ianm8/MBPTRX/README.md

# MBPTRX
A software defined multi-band phasing transceiver. See the [Manual](https://github.com/ianm8/MBPTRX/blob/main/docs/manual/MBPTRX_User_Manual.md) for further details.

## Some Specifications
 * SSB, CW, FM, FT8, Other digital modes using vox
 * 80m - 10m, nominally 10W
 * 3.5MHz - 30MHz SWL including AM
 * 30 KHz spectrum display
 * Noise reduction
 * Noise blanker
 * Notch filter

Here is a block diagram:

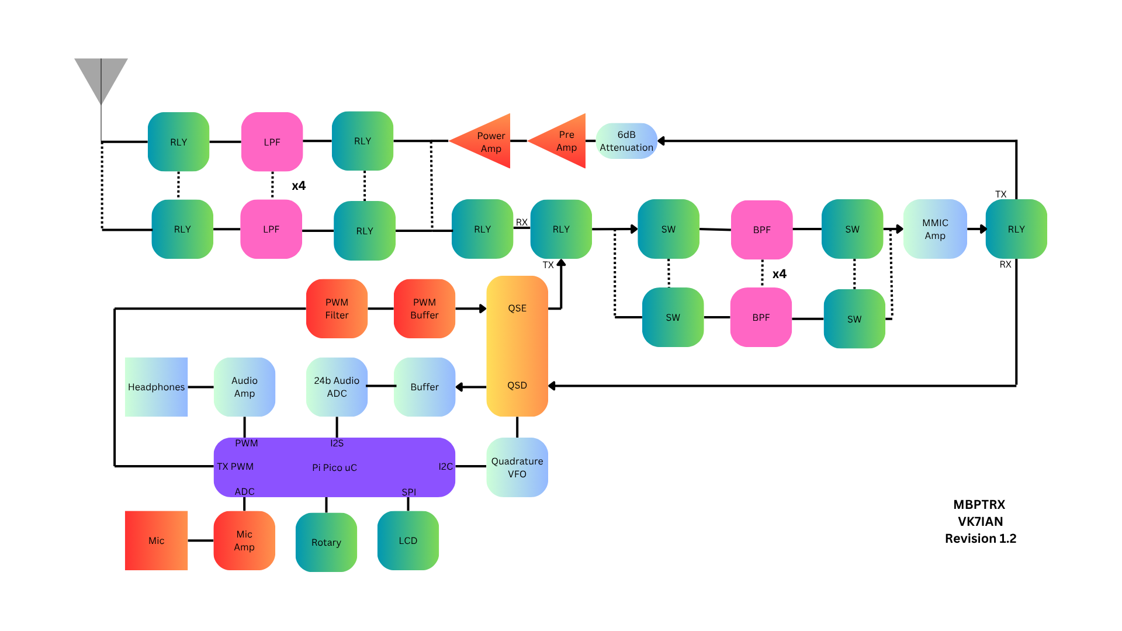
[picture p1: docs/MBPTRX.png]


Built in FT8:



Completed PCB:

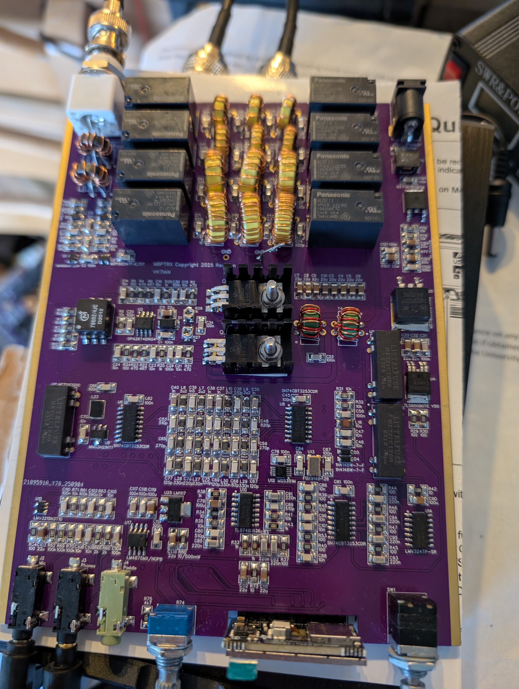
[picture p2: docs/MBPTRX-PCB-Complete.jpg]


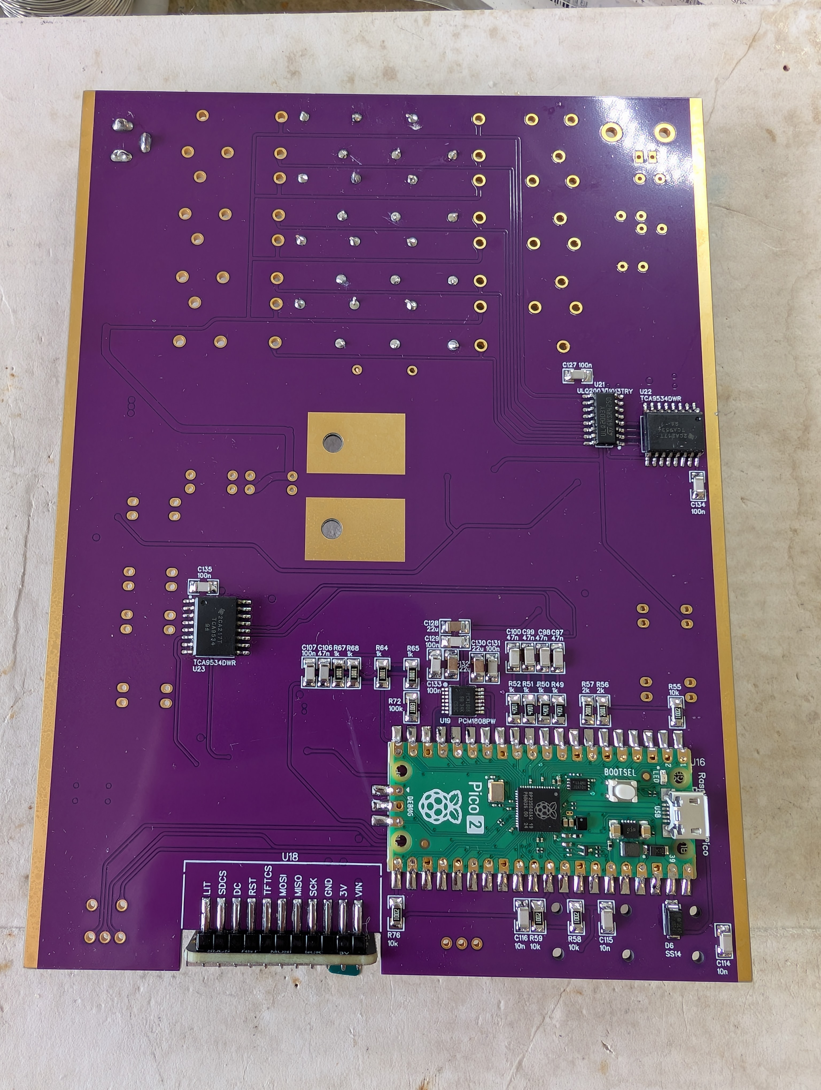
[picture p3: docs/MBPTRX-PCB-Bottom.jpg]


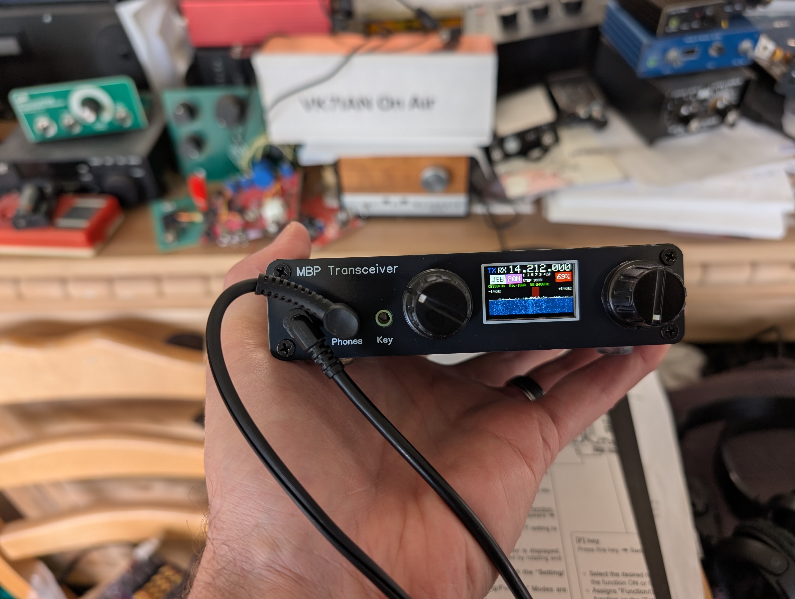
[picture p4: docs/MBPTRX-Boxed.jpg]


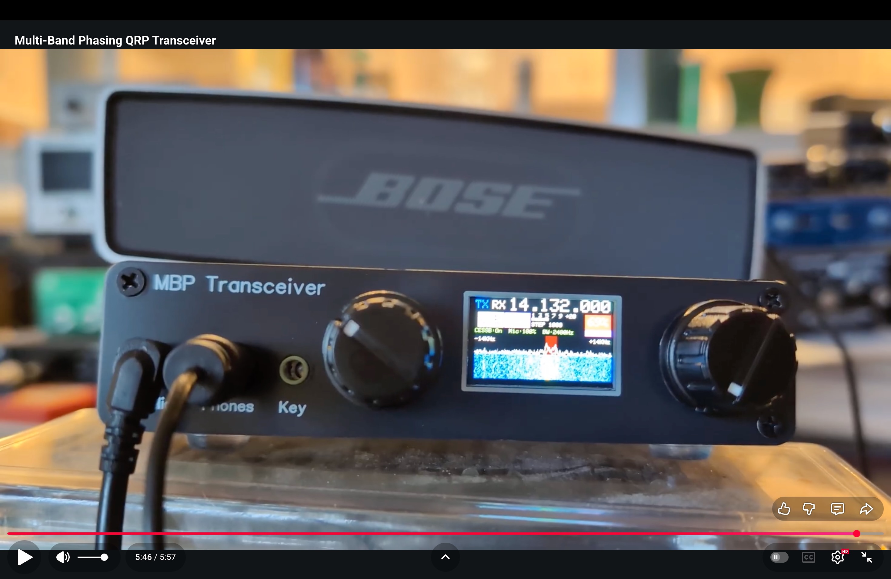
[picture p5: docs/MBPTRX-Short-Video.jpeg]
IMAGE ALT TEXT HERE (https://www.youtube.com/watch?v=c6KUVnFJ4gM)


73 VK7IAN
