ianm8/MBPTRX/src/README.md

## Libraries
 *  ~~https://github.com/Bodmer/TFT_eSPI~~
 *  A modified version of this library is now included
 *  Install the TFT_eSPI2 library provided in the **release** files
 *  This version adds a **displayOn()** function so that the display can be initialised and cleared before being switched on
 
## Build
 *  Pi Pico 2
 *  CPU Speed: 240Mhz
 *  Optimize: -O3
 *  USB Stack: No USB
 *  Flash Size: 4MB (no FS)

## Some history
 * 0.1.240 start with uSBITX and iqSDR40 code
 * 0.2.240 fix read I2C port bug
 * 0.3.240 fix RX/TX relay bug
 * 0.4.240 spectrum level
 * 0.5.240 direct CW
 * 0.6.240 complex mixer offset
 * 0.7.240 update bandwidths
 * 0.8.240 enable EEPROM writes
 * 0.9.240 fix CW display width
 * 1.0.240 RX bandwith options
 * 1.1.240 code cleanup
 * 1.2.240 fix SWR display
 * 1.3.240 graph power and SWR
 * 1.4.240 set spectrum level
 * 1.5.240 exit level if TX
 * 1.6.240 smeter sensitivity higher bands
 * 1.7.240 change TX frequency colour
 * 1.8.240 fix CW display position
 * 2.0.240 AM mode for SWL band
 * 2.1.240 improved AM demodulation
 * 2.2.240 include modified TFT_eSPI library
 * 2.3.240 fix TFT display initialisation
 * 2.4.240 separate modified TFT_eSPI2 library
 * 2.5.240 add exit option to JNR menu
 * 2.6.240 noise blanker
 * 2.7.240 TX/RX transition glitch
 * 2.8.240 reposition status info
 * 2.9.240 tweak noise blanker
 * 3.0.240 mic processor
 * 3.1.240 CW decoder - adaptive
 * 3.2.240 CW decoder - schmitt
 * 3.3.240 spectrum set or adjust
 * 3.4.240 update fonts
 * 4.0.240 digital mode with Vox
 * 4.1.240 don't show JNR in DIG mode
 * 4.2.240 lower sideband digital
 * 4.3.240 TX guard on startup
 * 4.4.240 minor update to spectrum processing
 * 5.0.240 FT8 built in
 * 5.1.240 FT8 refactor button press
 * 5.2.240 FT8 menu options
 * 5.3.240 FT8 pop-up CQ or response
 * 5.4.240 spectrum process regression
 * 5.5.240 FT8 progress resets on long press
 * 5.6.240 FT8 modifier seen as callsign
 * 5.7.240 FT8 fix frozen age colour
 * 5.8.240 FT8 detect poached QSO
 * 5.9.240 fix s-meter sensitivity
 * 6.0.240 improved spectrum (pedestal)
 * 6.1.240 improved CESSB
 * 6.2.240 improved sensitivity (AGC)
 * 6.3.240 core separate stacks
 * 6.4.240 notch filter
 * 6.5.240 reduce spectrum stack usage
 * 6.6.240 fix SWR graph mode
 * 6.7.240 fix frequency step
 * 6.8.240 move DSP to core1
 * 6.9.240 add popups
 * 7.0.240 user set callsign
 * 7.1.240 FT8 AGC display
 * 7.2.240 cw.h -> CW.h
 * 7.3.240 remove rotary err catch
 * 7.4.240 FT8 hashtable bounds
 * 7.5.240 ADC interrupt core1
 * 7.6.240 enforce build options
 * 7.7.240 improve all-pass accuracy
 * 7.8.240 improve noise blanker
 * 7.9.240 improve spectrum gain
 * 8.0.240 improve CW shaping
 * 8.1.240 FT8 auto-calibrate
 * 8.2.240 move mode auto
 * 8.3.240 add 10000 to quick step
 * 8.4.240 fix I2S backlog issue
 * 8.5.240 iambic A and B keyer
 * 8.6.240 FT8 monitoring
 * 8.7.240 robust float FFT
 * 8.8.240 FT8 unmute if monitoring
 * 8.9.240 FT8 clear autocal
 * 9.0.240 remove unused gaussian
 * 9.1.240 FT8 on Ham band only
 * 9.2.240 fix call entry message
 * 9.3.240 fix CW sidetone
 * 9.4.240 fix sidetone level
 * 9.5.240 FT8 autocal lock
 * 9.6.240 FT8 autocal shows first attempt
 * 9.7.240 add narrow band FM
