ianm8/MBPTRX/docs/PCB-Bottom-Photo-View.png

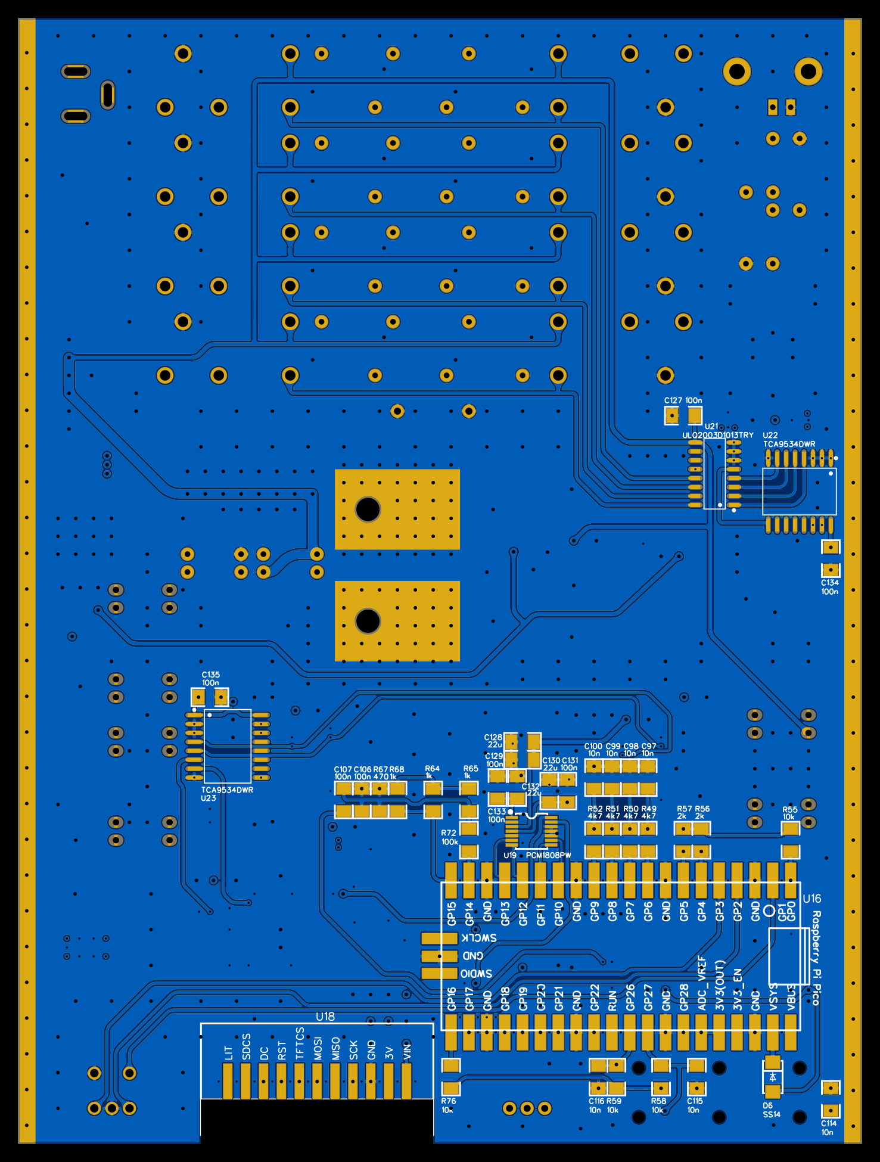
docs/PCB-Bottom-Photo-View.png
