ianm8/MBPTRX/docs/PCB-Top-Photo-View.png

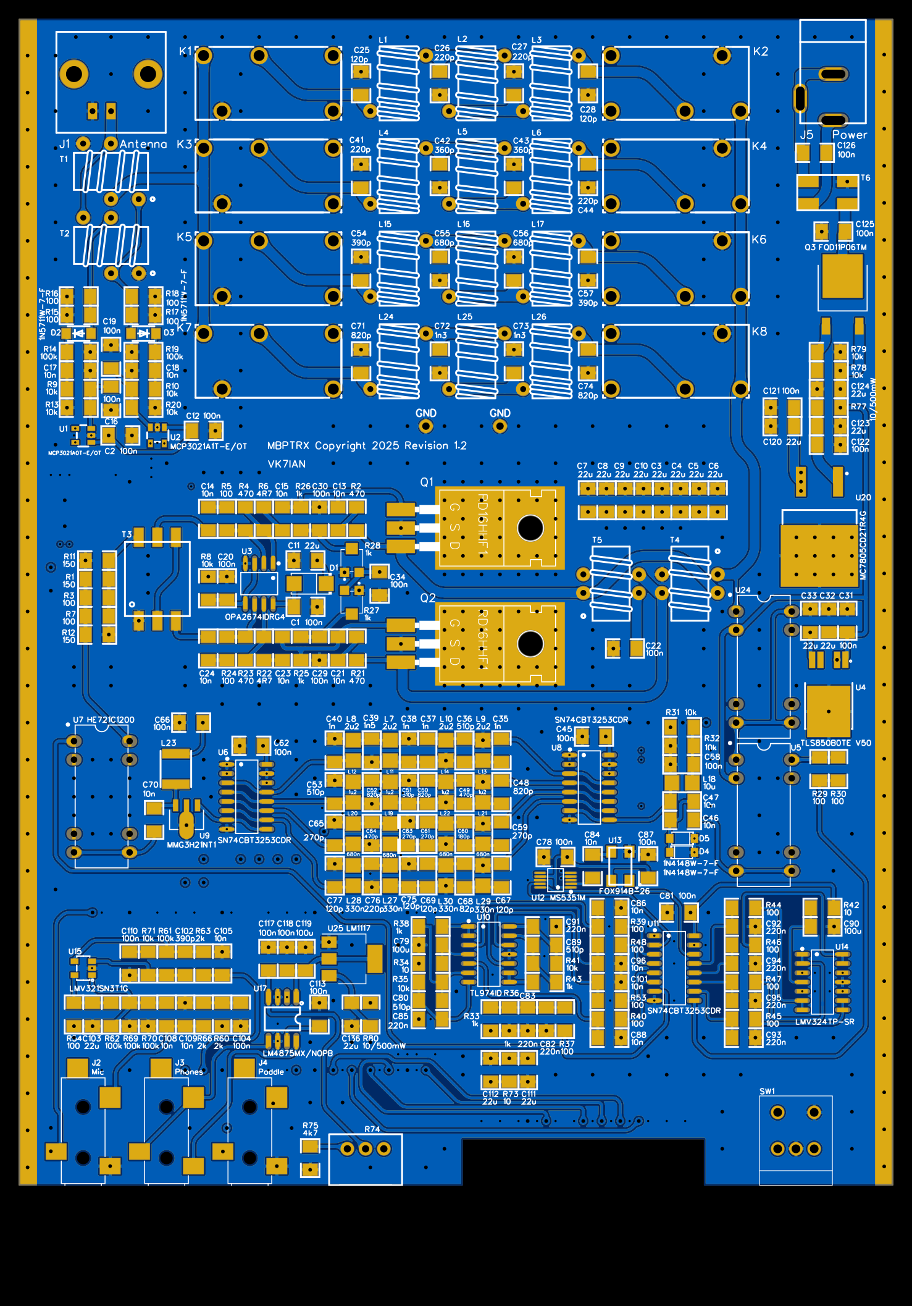
docs/PCB-Top-Photo-View.png
