ianm8/MBPTRX/docs/PXL_20250908_184102633.jpg

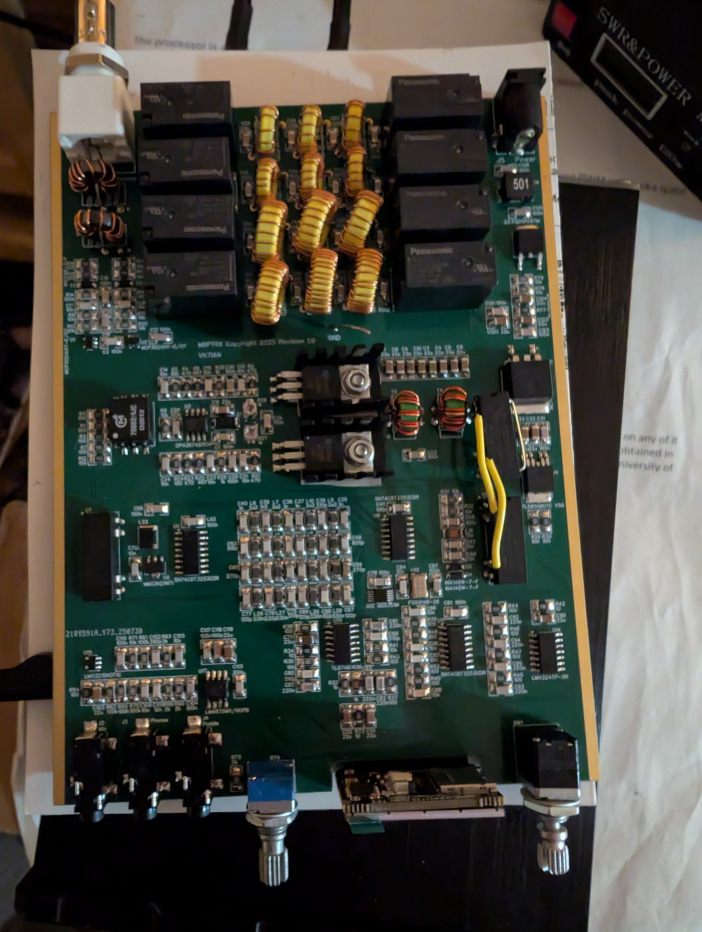
docs/PXL_20250908_184102633.jpg
