ianm8/MBPTRX/docs/suppression/RigolDS1-80M.png

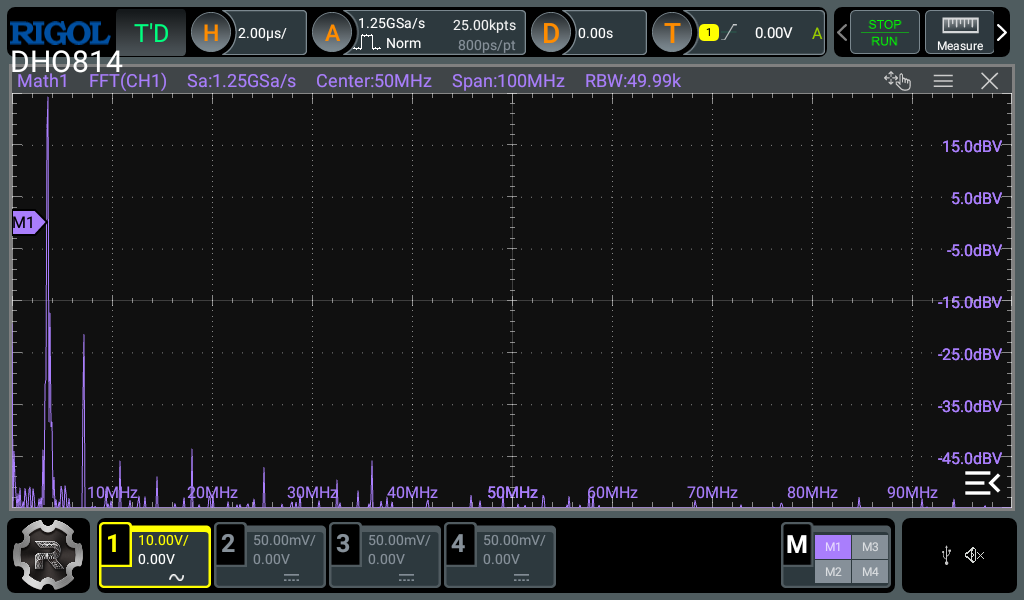
docs/suppression/RigolDS1-80M.png
