ianm8/MBPTRX/docs/suppression/RigolDS4-20M.png

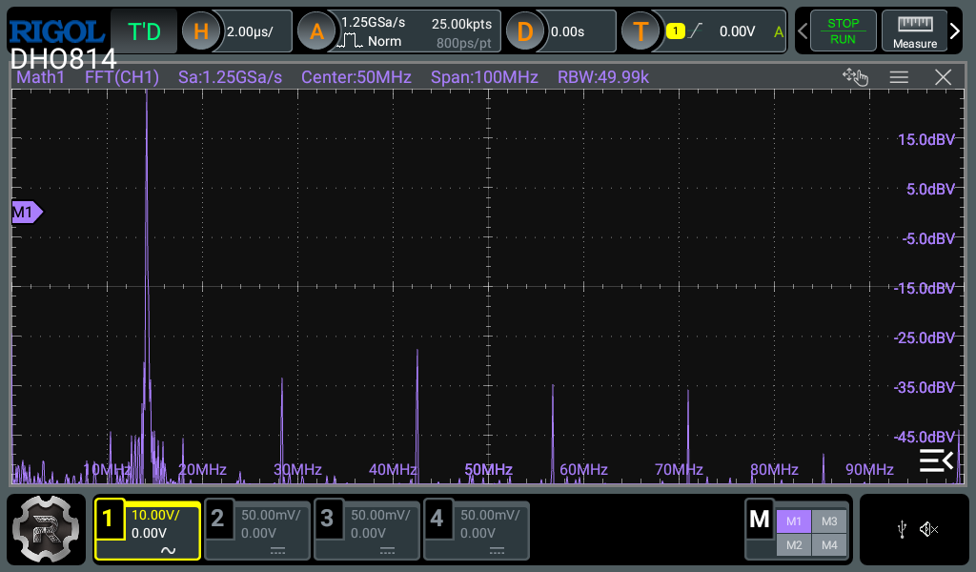
docs/suppression/RigolDS4-20M.png
