ianm8/MBPTRX/docs/suppression/RigolDS5-17M.png

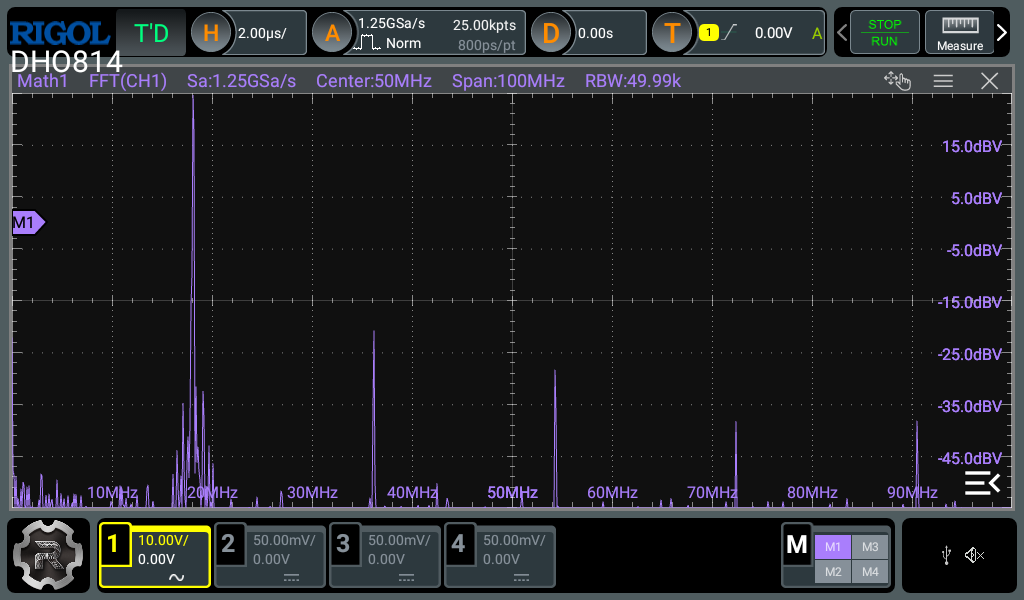
docs/suppression/RigolDS5-17M.png
