ianm8/MBPTRX/docs/suppression/RigolDS6-15M.png

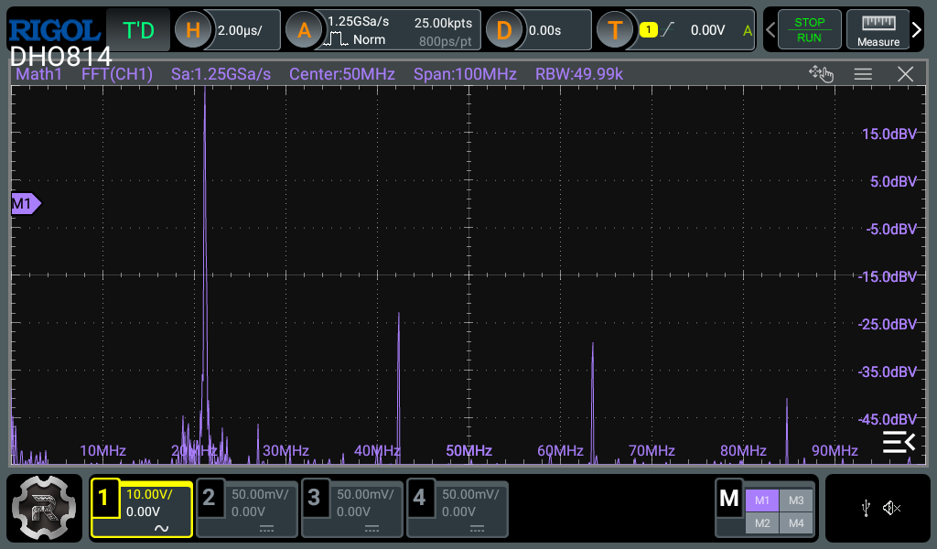
docs/suppression/RigolDS6-15M.png
