ianm8/MBPTRX/docs/suppression/RigolDS7-12M.png

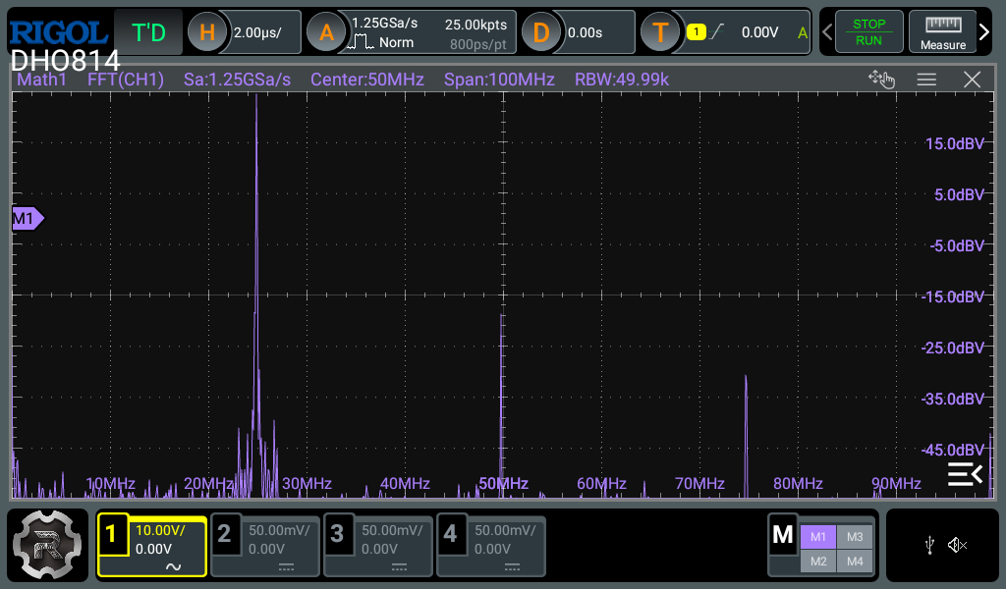
docs/suppression/RigolDS7-12M.png
