ianm8/MBPTRX/docs/suppression/RigolDS8-10M.png

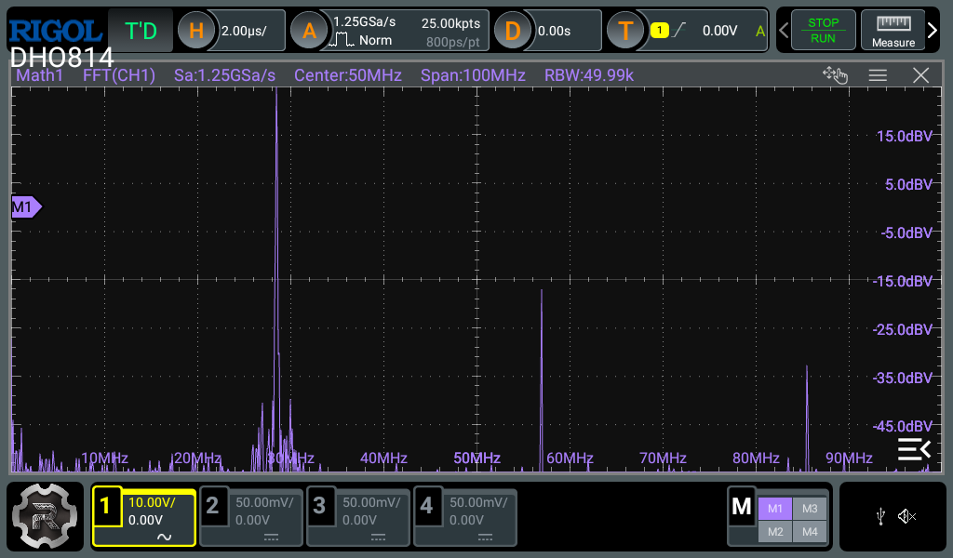
docs/suppression/RigolDS8-10M.png
