ianm8/MBPTRX/PCB/BOM_MBPTRX_2025-10-25.csv

ID | Name | Designator | Footprint | Quantity | Manufacturer Part | Manufacturer | Supplier | Supplier Part
1 | 10n | C13,C14,C15,C17,C18,C21,C23,C24,C46,C47,C70,C84,C86,C88,C96,C97,C98,C99,C100,C101,C105,C108,C109,C114,C115,C116 | 1206 | 26
2 | 4k7 | R49,R50,R51,R52,R75 | 1206 | 5 | ?
3 | 100n | C1,C2,C12,C16,C19,C20,C22,C29,C30,C31,C34,C45,C58,C62,C66,C78,C81,C87,C104,C106,C107,C110,C113,C117,C118,C121,C122,C125,C126,C127,C129,C131,C133,C134,C135 | 1206 | 35
4 | 22u | C3,C4,C5,C6,C7,C8,C9,C10,C11,C32,C33,C103,C111,C112,C120,C123,C124,C128,C130,C132,C136 | 1206 | 21
5 | ULQ2003D1013TRY | U21 | SOIC-16_L9.9-W3.9-P1.27-LS6.0-BL | 1 | ULQ2003D1013TR | STMicroelectronics | LCSC | C155642
6 | 1k | R64,R65,R68,R38,R43,R25,R26,R33,R36 | 1206 | 9 | ?
7 | 100k | R14,R19,R61,R62,R69,R70,R72 | 1206 | 7 | ?
8 | 2k | R56,R57,R60,R63,R66 | 1206 | 5 | ?
9 | PCM1808PW | U19 | TSSOP-14_L5.0-W4.4-P0.65-LS6.4-BL | 1 | PCM1808PW | TI(德州仪器) | Mouser
10 | Raspberry Pi Pico 2 Castellated | U16 | PI_PICO_RP2040 | 1 | Pi Pico 2 | Raspberry Pi Foundation | Raspberry Pi | Pi Pico 2
11 | SS14 | D6 | SMA_L4.4-W2.8-LS5.4-RD | 1 | SS14 | MDD | Mouser
12 | 10k | R8,R9,R10,R13,R20,R31,R32,R35,R41,R55,R58,R59,R71,R76,R78,R79 | 1206 | 16 | ?
13 | TCA9534DWR | U22,U23 | SOIC-16_L10.3-W7.5-P1.27-LS10.3-BL | 2 | TCA9534DWR | Texas Instruments | LCSC | C206010
14 | 470 | R2,R4,R21,R23,R67 | 1206 | 5 | ?
15 | 10/500mW | R80,R77 | 1206 | 2 | ? |  |  | 352210RJT
16 | LM1117 | U25 | SOT-223 | 1 | LM1117MP-5.0/NOPB | TI | LCSC | C131933
17 | 100u | C79,C90,C119 | 1206 | 3
18 | HE721C1200 | U24,U5,U7 | RELAY-TH_LITTELFUSE_HE700 | 3 | HE721C1200 | Littelfuse(美国力特) | LCSC | C1519209
19 | 390p | C54,C57,C102 | 1206 | 3
20 | 680p | C55,C56 | 1206 | 2
21 | 1u | L15,L16,L17 | T37-6 | 3
22 | RD16HHF1 | Q1,Q2 | TO220 | 2
23 | 120p | C25,C28,C67,C69,C75,C77 | 1206 | 6
24 | 220p | C26,C27,C41,C44,C76 | 1206 | 5
25 | 1n | C35,C37,C38,C40 | 1206 | 4
26 | 510p | C36,C51,C53,C80,C89 | 1206 | 5
27 | 1n5 | C39 | 1206 | 1
28 | 360p | C42,C43 | 1206 | 2
29 | 820p | C48,C50,C52,C71,C74 | 1206 | 5
30 | 470p | C49,C64 | 1206 | 2
31 | 270p | C59,C61,C63,C65 | 1206 | 4
32 | 180p | C60 | 1206 | 1
33 | 82p | C68 | 1206 | 1
34 | 1n3 | C72,C73 | 1206 | 2
35 | 220n | C82,C83,C85,C91,C92,C93,C94,C95 | 1206 | 8
36 | 10 | R73,R34,R42 | 1206 | 3 | ?
37 | 10k | R74 | BOURNS_PTD901_1GANG | 1 | PTD901-1015F-B103 | Bourns | Mouser | PTD901-1015F-B103
38 | 150 | R1,R11,R12 | 1206 | 3 | ?
39 | 100 | R3,R5,R7,R15,R16,R17,R18,R24,R29,R30,R37,R39,R40,R44,R45,R46,R47,R48,R53,R54 | 1206 | 20 | ?
40 | 4R7 | R6,R22 | 1206 | 2 | ?
41 | BZG05C3V3-M3-08 | D1 | SMA_L4.3-W2.6-LS5.2-RD | 1 | BZG05C3V3-M3-08 | VISHAY(威世) | LCSC | C467520
42 | 1N5711W-7-F | D2,D3 | SOD-123_L2.8-W1.8-LS3.7-RD | 2 | 1N5711W-7-F | Diodes Incorporated | LCSC | C154843
43 | 1N4148W-7-F | D4,D5 | SOD-123_L2.8-W1.8-LS3.7-RD | 2 | 1N4148W-7-F | DIODES | LCSC | C83528
44 | Antenna | J1 | BNC_PCB | 1 |  |  | Mouser | 5227161
45 | Mic | J2 | CUI_SJ-3524-SMT | 1 |  |  |  | SJ-3524-SMT
46 | Phones | J3 | CUI_SJ-3524-SMT | 1 |  |  |  | SJ-3524-SMT
47 | Paddle | J4 | CUI_SJ-3524-SMT | 1 |  |  |  | SJ-3524-SMT
48 | Power | J5 | DC-072-165A | 1 | PJ-002AH | Same Sky | Mouser
49 | ALQ112 | K1,K2,K3,K4,K5,K6,K7,K8 | RELAY-TH_ALQ1XX | 8 | ALQ112 | PANASONIC(松下) | LCSC | C425091
50 | 330n | L1,L3 | T37-6 | 2
51 | 360n | L2 | T37-6 | 1
52 | 560n | L4,L6 | T37-6 | 2
53 | 620n | L5 | T37-6 | 1
54 | 2u2 | L24,L25,L26 | T37-6 | 3
55 | 10u | L18 | 120608 | 1 | AISM-1812-1R0K |  |  | 1206F-100K-01
56 | FQD11P06TM | Q3 | DPAK-3_L6.6-W6.1-P2.28-LS9.9-BR | 1 | FQD11P06TM | ON Semiconductor | Mouser
57 | 1k | R27,R28 | 35WR1KLFTR | 2 |  |  |  | 35WR1KLFTR
58 | PEC09-SWITCH-T | SW1 | PEC09-SWITCH-T | 1 | PEC09-2320F-T0015 | Bourns | Digi-Key | 652-PEC092320FT0015
59 | FT37_SENSE_TRANSFORMER | T1,T2 | FT37_SENSE_TRANSFORMER | 2
60 | 78602/4JC-2 | T3 | 78602SM | 1
61 | SHO-301 | T4,T5 | SHO-301 | 2 |  |  |  | SHO-301
62 | PA4339.501 | T6 | PA4339.501NLT FOOTPRINT | 1 | PA4339.501NLT | Pulse Electronics Power | Mouser | PA4339.501NLT
63 | MCP3021A0T-E/OT | U1 | SOT-23-5_L2.9-W1.6-P0.95-LS2.8-BR | 1 | MCP3021A0T-E/OT | MICROCHIP(美国微芯) | LCSC | C625465
64 | MCP3021A1T-E/OT | U2 | SOT-23-5_L2.9-W1.6-P0.95-LS2.8-BR | 1 | MCP3021A1T-E/OT | MICROCHIP(美国微芯) | LCSC | C5127749
65 | TLS850B0TE V50 | U4 | PG-TO252-5_L6.5-W6.3-P1.14-LS10.0-BR | 1 | TLS850B0TE V50 | Infineon(英飞凌) | LCSC | C540294
66 | SN74CBT3253CDR | U11 | SOIC-16_L9.9-W3.9-P1.27-LS6.0-BL | 1 | SN74CBT3253PWR | Texas Instruments | Mouser
67 | MS5351M | U12 | MSOP-10_L3.0-W3.0-P0.50-LS5.0-BL | 1 | MS5351M | 杭州瑞盟 | LCSC | C1509083
68 | FOX924B-26 | U13 | FOX924B | 1 | FOX924B-25 | Fox | Mouser | 559-FOX924B-25
69 | LMV321SN3T1G | U15 | TSOP-5_L3.0-W1.5-P0.95-BL | 1 | LMV321SN3T1G |  | Mouser
70 | LM4875MX/NOPB | U17 | SOIC-8 | 1 | LM4875MX/NOPB | TI | LCSC | C134135
71 | LCD | U18 | LCD4383SM | 1 | 4383 | null | Mouser | 485-4383
72 | MC7805CD2TR4G | U20 | TO-263-2_L10.0-W9.1-P5.08-LS15.2-TL | 1 | MC7805CD2TR4G | onsemi | Mouser | 863-MC7805CD2TR4G
73 | OPA2674IDRG4 | U3 | SOIC-8_L4.9-W3.9-P1.27-LS6.0-BL | 1 | OPA2674IDRG4 | TI(德州仪器) | LCSC | C2060106
74 | TL974ID | U10 | SOIC-14_L8.7-W3.9-P1.27-LS6.0-BL | 1 | TL974ID | TI(德州仪器) | Mouser | C1347110
75 | LMV324TP-SR | U14 | SOIC-14_L8.7-W3.9-P1.27-LS6.0-BL | 1 | 3PEAK | LMV324TP-SR | Mouser | C90298
76 | 2u2 | L7,L8,L9,L10 | 120608 | 4 | AISM-1812-1R0K |  |  | AISM-1812-1R0K
77 | 1u2 | L11,L12,L13,L14 | 120608 | 4 | AISM-1812-1R0K |  |  | AISM-1812-1R0K
78 | 680n | L19,L20,L21,L22 | 120608 | 4 | AISM-1812-1R0K |  |  | AISM-1812-1R0K
79 | 330n | L27,L28,L29,L30 | 120608 | 4 | AISM-1812-1R0K |  |  | AISM-1812-1R0K
80 | PFL4514-153MEC | L23 | PFL4514-SM | 1 | PFL4514 | Coilcraft |  | PFL4514
81 | SN74CBT3253CDR | U6,U8 | SOIC-16_L9.9-W3.9-P1.27-LS6.0-BL | 2 | SN74CBT3253PWR | Texas Instruments | Digi-Key | C424399
82 | MMG3H21NT1 | U9 | SOT-89-3_L4.5-W2.5-P1.50-LS4.2-BR | 1 | MMG3H21NT1 | NXP |  | C2151398
