ianm8/MBPTRX/docs/manual/README.md

# User Manual

Here is a user manual in both MD and PDF format. Currently based on version 9.7.240
