ianm8/MBPTRX/docs/Schematic_MBPTRX_2025-10-20.pdf

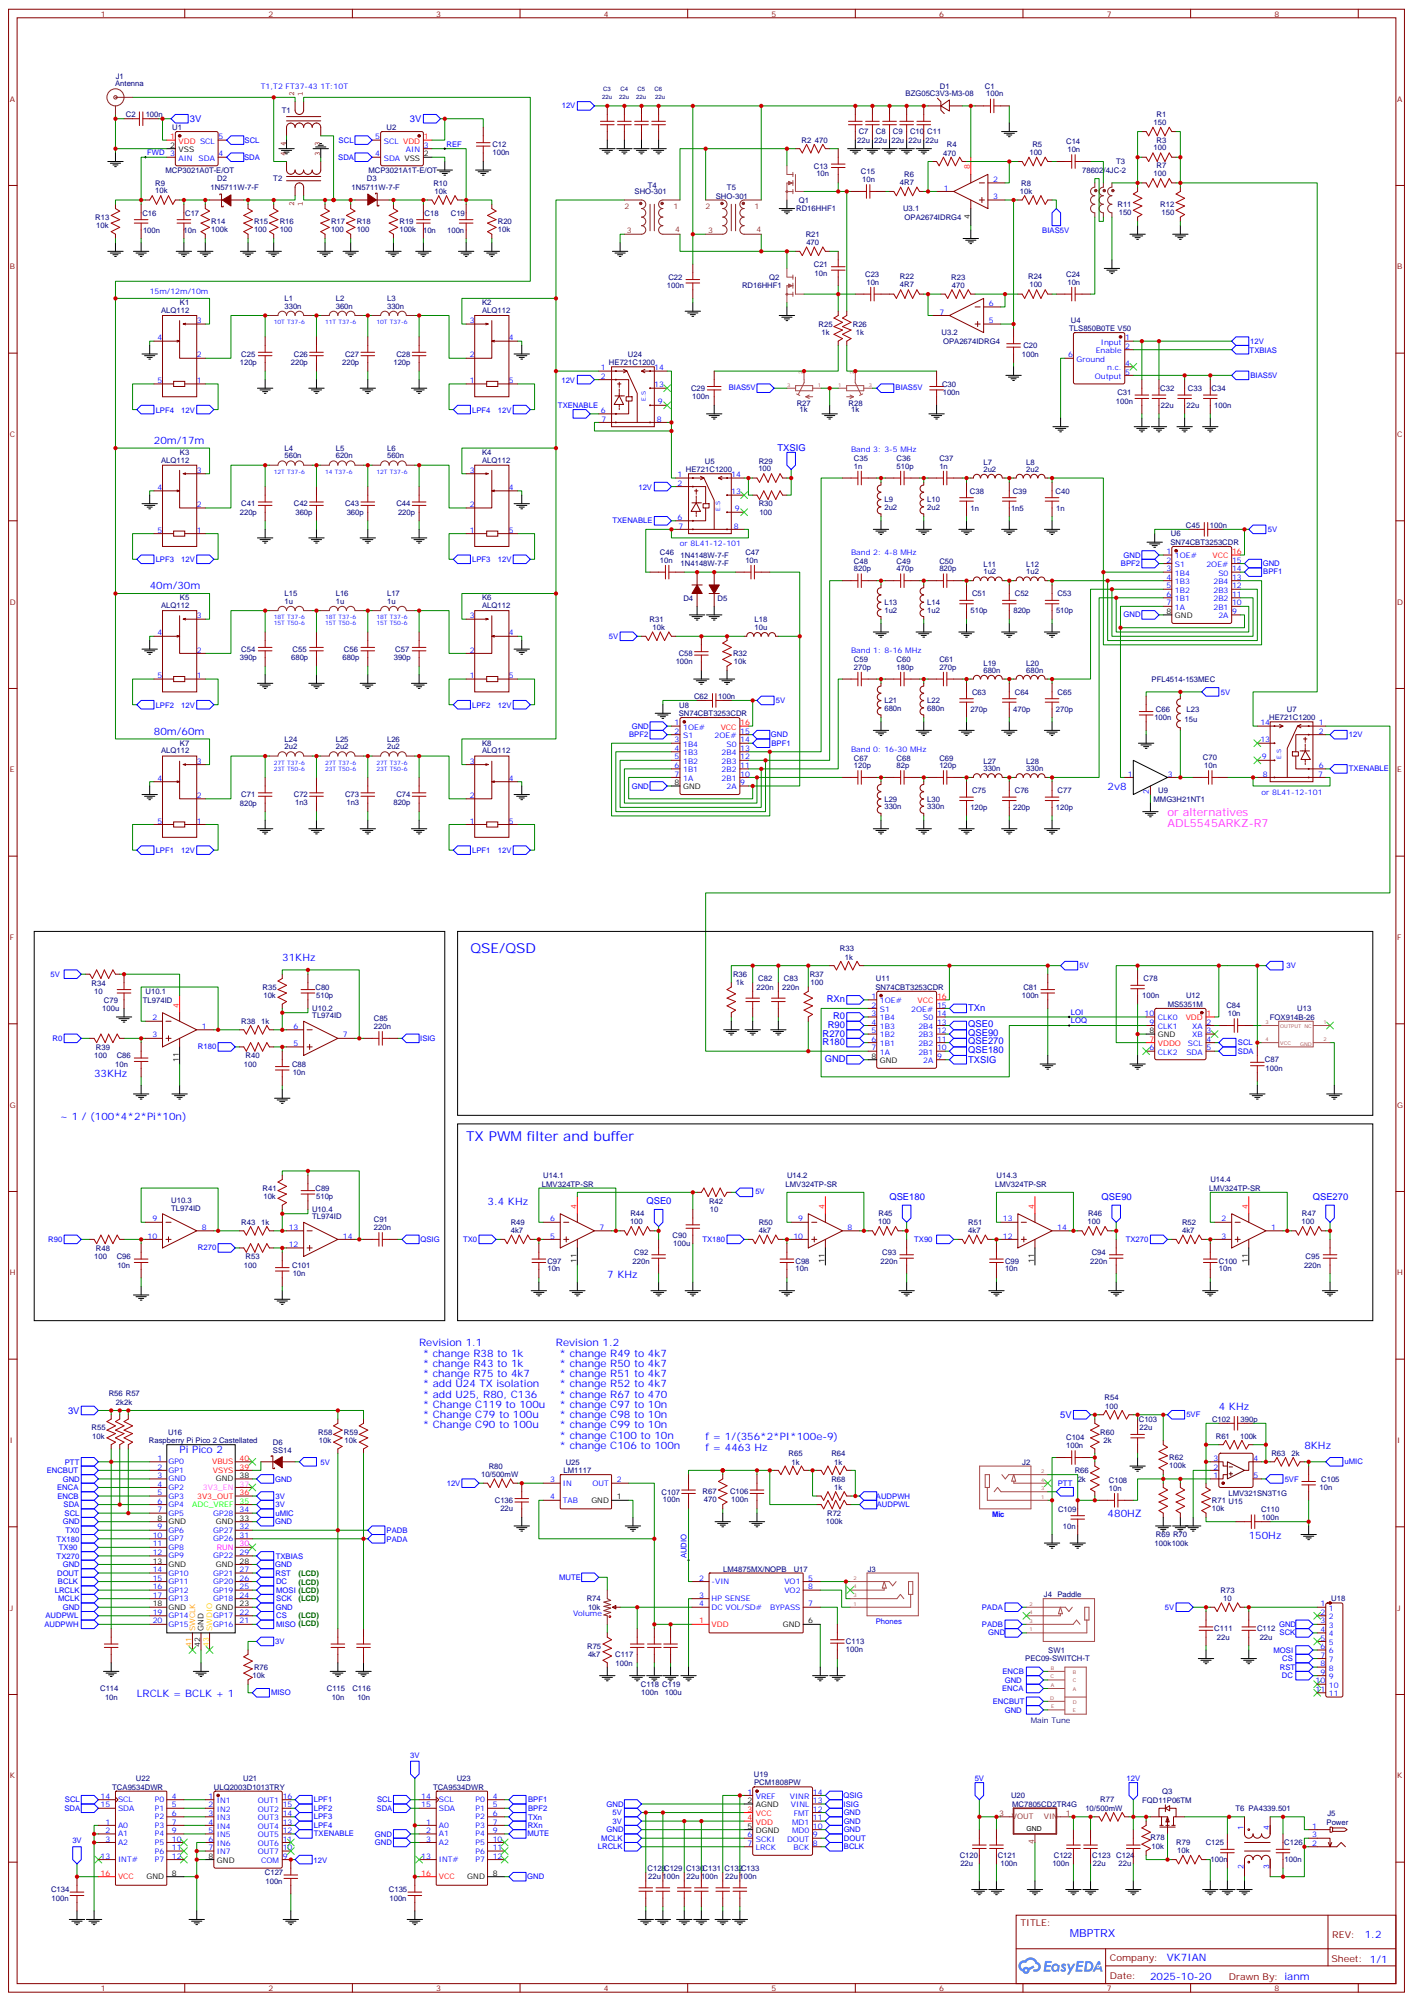
[picture p15: page 1]

TX PWM filter and buffer

Raspberry Pi Pico 2 Castellated

LM4875MX/NOPB U17
HP SENSE 3
BYPASS 7 DC VOL/SD# 4
VDD 1
