ianm8/MBPTRX/PCB/PCB-Bottom.pdf

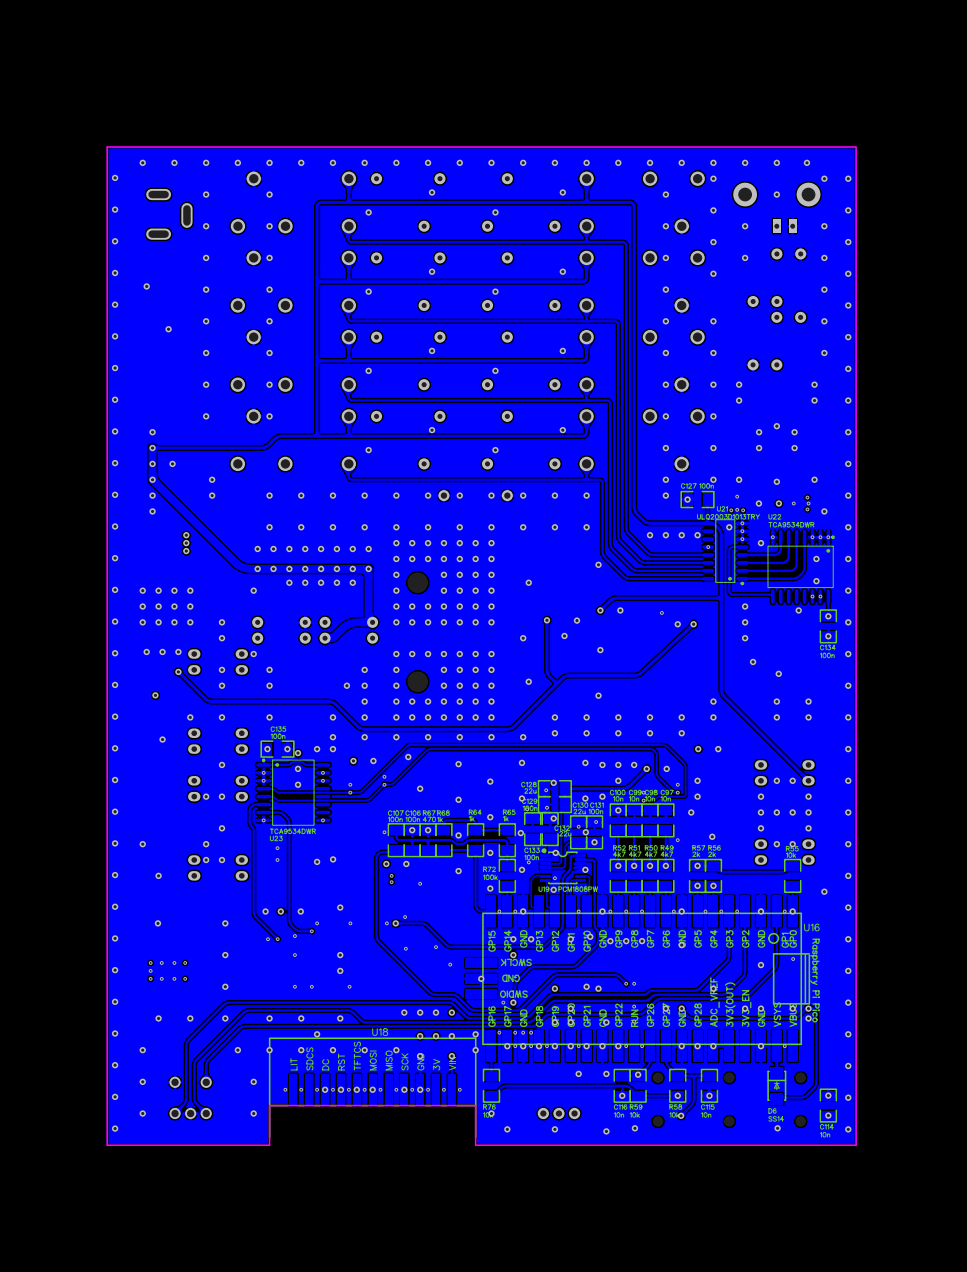
[picture p16: page 1]
