ianm8/MBPTRX/PCB/PCB-Top.pdf

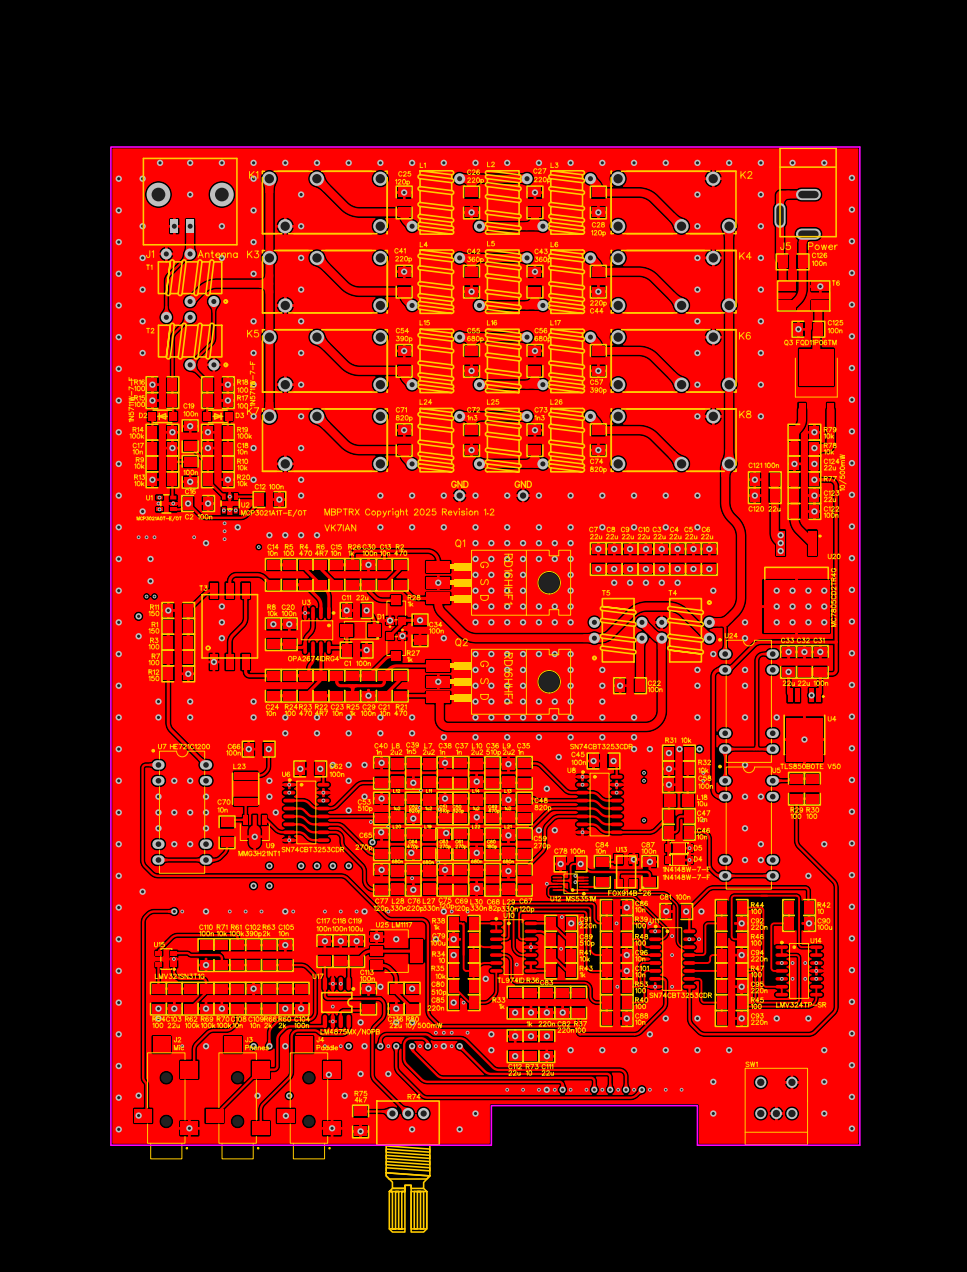
[picture p17: page 1]
