ianm8/MBPTRX/src/menu.h

#ifndef MENU_H
#define MENU_H

/*

 Step
  10
  100
  500
  1000
  10000
  Exit

 Mode
   LSB
   USB
   CWL
   CWU
   Auto
   Exit

  Band
    80M
    40M
    ...
    Exit

  ...

  Exit
    Exit

*/

// FM: one more menu (FM Squelch), and Mode now has 11 options
#define NUM_MENU_ITEMS 21U
#define NUM_MENU_OPTIONS 11U

enum menu_top_t
{
  MENU_BAND,
  MENU_STEP,
  MENU_MODE,
  MENU_BANDWIDTH,
  MENU_NOTCH,
  MENU_SQUELCH,
  MENU_CW_SPEED,
  MENU_CW_DECODE,
  MENU_SIDETONE,
  MENU_CW_KEYER,
  MENU_SIDETONE_LEVEL,
  MENU_SPECTRUM_TYPE,
  MENU_JNR,
  MENU_NB,
  MENU_MIC,
  MENU_MIC_PROC,
  MENU_CESSB,
  MENU_GRAPH_SWR,
  MENU_FT8,
  MENU_CALLSIGN,
  MENU_EXIT
};

enum option_value_t
{
  OPTION_STEP_10,
  OPTION_STEP_100,
  OPTION_STEP_500,
  OPTION_STEP_1000,
  OPTION_STEP_5000,
  OPTION_STEP_10000,
  OPTION_STEP_100000,
  OPTION_MODE_USB,
  OPTION_MODE_LSB,
  OPTION_MODE_CWL,
  OPTION_MODE_CWU,
  OPTION_MODE_DGL,
  OPTION_MODE_DGU,
  OPTION_MODE_FT8,
  OPTION_MODE_AM,
  OPTION_MODE_FM,
  OPTION_MODE_AUTO,
  OPTION_BAND_80M,
  OPTION_BAND_40M,
  OPTION_BAND_30M,
  OPTION_BAND_20M,
  OPTION_BAND_17M,
  OPTION_BAND_15M,
  OPTION_BAND_12M,
  OPTION_BAND_10M,
  OPTION_BAND_SWL,
  OPTION_BW_2000,
  OPTION_BW_2200,
  OPTION_BW_2400,
  OPTION_BW_2600,
  OPTION_BW_2800,
  OPTION_NOTCH_ON,
  OPTION_NOTCH_OFF,
  OPTION_CW_SPEED_10,
  OPTION_CW_SPEED_15,
  OPTION_CW_SPEED_20,
  OPTION_CW_SPEED_25,
  OPTION_CW_SPEED_30,
  OPTION_DECODE_ADAPTIVE,
  OPTION_DECODE_SCHMITT,
  OPTION_CWDECODE_OFF,
  OPTION_SIDETONE_600,
  OPTION_SIDETONE_650,
  OPTION_SIDETONE_700,
  OPTION_SIDETONE_750,
  OPTION_SIDETONE_800,
  OPTION_SIDETONE_LOW,
  OPTION_SIDETONE_MED,
  OPTION_SIDETONE_HI,
  OPTION_IAMBIC_A,
  OPTION_IAMBIC_B,
  OPTION_SPECTRUM_WIND,
  OPTION_SPECTRUM_GRASS,
  OPTION_SPEC_SETLEVEL,
  OPTION_SPEC_ADJLEVEL,
  OPTION_JNR_OFF,
  OPTION_JNR_LEVEL1,
  OPTION_JNR_LEVEL2,
  OPTION_JNR_LEVEL3,
  OPTION_NB_OFF,
  OPTION_NB_LEVEL1,
  OPTION_NB_LEVEL2,
  OPTION_NB_LEVEL3,
  OPTION_NB_LEVEL4,
  OPTION_NB_LEVEL5,
  OPTION_SQL_OFF,
  OPTION_SQL_LEVEL1,
  OPTION_SQL_LEVEL2,
  OPTION_SQL_LEVEL3,
  OPTION_SQL_LEVEL4,
  OPTION_SQL_LEVEL5,
  OPTION_MIC_25,
  OPTION_MIC_50,
  OPTION_MIC_75,
  OPTION_MIC_100,
  OPTION_MIC_125,
  OPTION_MIC_150,
  OPTION_MIC_175,
  OPTION_MIC_200,
  OPTION_MIC_PROC_OFF,
  OPTION_MIC_PROC1,
  OPTION_MIC_PROC2,
  OPTION_MIC_PROC3,
  OPTION_MIC_PROC4,
  OPTION_MIC_PROC5,
  OPTION_CESSB_ON,
  OPTION_CESSB_OFF,
  OPTION_GRAPH_SWR_Y,
  OPTION_GRAPH_SWR_N,
  OPTION_FT8_CQ_CQ,
  OPTION_FT8_CQ_DX,
  OPTION_FT8_CQ_WWFF,
  OPTION_FT8_CQ_POTA,
  OPTION_FT8_CQ_SOTA,
  OPTION_FT8_CALSET,
  OPTION_FT8_AUTOCAL,
  OPTION_FT8_MONITOR_ON,
  OPTION_FT8_MONITOR_OFF,
  OPTION_CALL_RESET,
  OPTION_CALL_REBOOT,
  OPTION_NONE,
  OPTION_EXIT
};

struct options_t
{
  option_value_t option_value;
  const char* option_name;
};

static const struct
{
  const menu_top_t menu_value;
  const char *menu_name;
  const uint8_t num_options;
  const options_t options[NUM_MENU_OPTIONS];
}
menu_options[NUM_MENU_ITEMS] =
{
  {
    MENU_BAND,
    "Band",
    10U,
    {
      {OPTION_BAND_80M,"80M"},
      {OPTION_BAND_40M,"40M"},
      {OPTION_BAND_30M,"30M"},
      {OPTION_BAND_20M,"20M"},
      {OPTION_BAND_17M,"17M"},
      {OPTION_BAND_15M,"15M"},
      {OPTION_BAND_12M,"12M"},
      {OPTION_BAND_10M,"10M"},
      {OPTION_BAND_SWL,"SWL"},
      {OPTION_EXIT,"Exit"},
      {OPTION_NONE,"None"}
    }
  },
  {
    MENU_STEP,
    "Step",
    8U,
    {
      {OPTION_STEP_10,"10"},
      {OPTION_STEP_100,"100"},
      {OPTION_STEP_500,"500"},
      {OPTION_STEP_1000,"1000"},
      {OPTION_STEP_5000,"5000"},
      {OPTION_STEP_10000,"10000"},
      {OPTION_STEP_100000,"100000"},
      {OPTION_EXIT,"Exit"},
      {OPTION_NONE,"None"},
      {OPTION_NONE,"None"},
      {OPTION_NONE,"None"}
    }
  },
  {
    MENU_MODE,
    "Mode",
    11U,
    {
      {OPTION_MODE_AUTO,"AUTO"},
      {OPTION_MODE_LSB,"LSB"},
      {OPTION_MODE_USB,"USB"},
      {OPTION_MODE_CWL,"CWL"},
      {OPTION_MODE_CWU,"CWU"},
      {OPTION_MODE_DGL,"DGL"},
      {OPTION_MODE_DGU,"DGU"},
      {OPTION_MODE_FT8,"FT8"},
      {OPTION_MODE_AM,"AM"},
      {OPTION_MODE_FM,"FM"},
      {OPTION_EXIT,"Exit"}
    }
  },
  {
    MENU_JNR,
    "JNR",
    5U,
    {
      {OPTION_JNR_LEVEL1,"Level 1"},
      {OPTION_JNR_LEVEL2,"Level 2"},
      {OPTION_JNR_LEVEL3,"Level 3"},
      {OPTION_JNR_OFF,"Off"},
      {OPTION_EXIT,"Exit"},
      {OPTION_NONE,"None"},
      {OPTION_NONE,"None"},
      {OPTION_NONE,"None"},
      {OPTION_NONE,"None"},
      {OPTION_NONE,"None"},
      {OPTION_NONE,"None"}
    }
  },
  {
    MENU_NB,
    "Blanker",
    7U,
    {
      {OPTION_NB_LEVEL1,"Level 1"},
      {OPTION_NB_LEVEL2,"Level 2"},
      {OPTION_NB_LEVEL3,"Level 3"},
      {OPTION_NB_LEVEL4,"Level 4"},
      {OPTION_NB_LEVEL5,"Level 5"},
      {OPTION_NB_OFF,"Off"},
      {OPTION_EXIT,"Exit"},
      {OPTION_NONE,"None"},
      {OPTION_NONE,"None"},
      {OPTION_NONE,"None"},
      {OPTION_NONE,"None"}
    }
  },
  {
    MENU_BANDWIDTH,
    "Bandwidth",
    6U,
    {
      {OPTION_BW_2000,"2000 Hz"},
      {OPTION_BW_2200,"2200 Hz"},
      {OPTION_BW_2400,"2400 Hz"},
      {OPTION_BW_2600,"2600 Hz"},
      {OPTION_BW_2800,"2800 Hz"},
      {OPTION_EXIT,"Exit"},
      {OPTION_NONE,"None"},
      {OPTION_NONE,"None"},
      {OPTION_NONE,"None"},
      {OPTION_NONE,"None"},
      {OPTION_NONE,"None"}
    }
  },
  {
    MENU_NOTCH,
    "Notch Filter",
    3U,
    {
      {OPTION_NOTCH_ON,"Notch On"},
      {OPTION_NOTCH_OFF,"Notch Off"},
      {OPTION_EXIT,"Exit"},
      {OPTION_NONE,"None"},
      {OPTION_NONE,"None"},
      {OPTION_NONE,"None"},
      {OPTION_NONE,"None"},
      {OPTION_NONE,"None"},
      {OPTION_NONE,"None"},
      {OPTION_NONE,"None"},
      {OPTION_NONE,"None"}
    }
  },
  {
    MENU_SQUELCH,
    "FM Squelch",
    7U,
    {
      {OPTION_SQL_LEVEL1,"Level 1"},
      {OPTION_SQL_LEVEL2,"Level 2"},
      {OPTION_SQL_LEVEL3,"Level 3"},
      {OPTION_SQL_LEVEL4,"Level 4"},
      {OPTION_SQL_LEVEL5,"Level 5"},
      {OPTION_SQL_OFF,"Off"},
      {OPTION_EXIT,"Exit"},
      {OPTION_NONE,"None"},
      {OPTION_NONE,"None"},
      {OPTION_NONE,"None"},
      {OPTION_NONE,"None"}
    }
  },
  {
    MENU_FT8,
    "FT8 Options",
    10U,
    {
      {OPTION_FT8_CQ_CQ,"CQ"},
      {OPTION_FT8_CQ_DX,"CQ DX"},
      {OPTION_FT8_CQ_WWFF,"CQ WWFF"},
      {OPTION_FT8_CQ_POTA,"CQ POTA"},
      {OPTION_FT8_CQ_SOTA,"CQ SOTA"},
      {OPTION_FT8_CALSET,"Reset Cal"},
      {OPTION_FT8_AUTOCAL,"Auto Cal"},
      {OPTION_FT8_MONITOR_ON,"Monitor On"},
      {OPTION_FT8_MONITOR_OFF,"Monitor Off"},
      {OPTION_EXIT,"Exit"},
      {OPTION_NONE,"None"}
    }
  },
  {
    MENU_SPECTRUM_TYPE,
    "Spectrum",
    5U,
    {
      {OPTION_SPECTRUM_WIND,"Wind"},
      {OPTION_SPECTRUM_GRASS,"Grass"},
      {OPTION_SPEC_SETLEVEL,"Set Level"},
      {OPTION_SPEC_ADJLEVEL,"Adj Level"},
      {OPTION_EXIT,"Exit"},
      {OPTION_NONE,"None"},
      {OPTION_NONE,"None"},
      {OPTION_NONE,"None"},
      {OPTION_NONE,"None"},
      {OPTION_NONE,"None"},
      {OPTION_NONE,"None"}
    }
  },
  {
    MENU_MIC,
    "Mic Gain",
    9U,
    {
      {OPTION_MIC_25,"Gain 25%"},
      {OPTION_MIC_50,"Gain 50%"},
      {OPTION_MIC_75,"Gain 75%"},
      {OPTION_MIC_100,"Gain 100%"},
      {OPTION_MIC_125,"Gain 125%"},
      {OPTION_MIC_150,"Gain 150%"},
      {OPTION_MIC_175,"Gain 175%"},
      {OPTION_MIC_200,"Gain 200%"},
      {OPTION_EXIT,"Exit"},
      {OPTION_NONE,"None"},
      {OPTION_NONE,"None"}
    }
  },
  {
    MENU_MIC_PROC,
    "Mic Proc",
    7U,
    {
      {OPTION_MIC_PROC1,"Level 1"},
      {OPTION_MIC_PROC2,"Level 2"},
      {OPTION_MIC_PROC3,"Level 3"},
      {OPTION_MIC_PROC4,"Level 4"},
      {OPTION_MIC_PROC5,"Level 5"},
      {OPTION_MIC_PROC_OFF,"Off"},
      {OPTION_EXIT,"Exit"},
      {OPTION_NONE,"None"},
      {OPTION_NONE,"None"},
      {OPTION_NONE,"None"},
      {OPTION_NONE,"None"}
    }
  },
  {
    MENU_CW_DECODE,
    "CW Decode",
    4U,
    {
      {OPTION_DECODE_ADAPTIVE,"Adaptive"},
      {OPTION_DECODE_SCHMITT,"Schmitt"},
      {OPTION_CWDECODE_OFF,"Off"},
      {OPTION_EXIT,"Exit"},
      {OPTION_NONE,"None"},
      {OPTION_NONE,"None"},
      {OPTION_NONE,"None"},
      {OPTION_NONE,"None"},
      {OPTION_NONE,"None"},
      {OPTION_NONE,"None"},
      {OPTION_NONE,"None"}
    }
  },
  {
    MENU_CW_SPEED,
    "CW Speed",
    6U,
    {
      {OPTION_CW_SPEED_10,"10 WPM"},
      {OPTION_CW_SPEED_15,"15 WPM"},
      {OPTION_CW_SPEED_20,"20 WPM"},
      {OPTION_CW_SPEED_25,"25 WPM"},
      {OPTION_CW_SPEED_30,"30 WPM"},
      {OPTION_EXIT,"Exit"},
      {OPTION_NONE,"None"},
      {OPTION_NONE,"None"},
      {OPTION_NONE,"None"},
      {OPTION_NONE,"None"},
      {OPTION_NONE,"None"}
    }
  },
  {
    MENU_SIDETONE,
    "CW Tone",
    6U,
    {
      {OPTION_SIDETONE_600,"600 Hz"},
      {OPTION_SIDETONE_650,"650 Hz"},
      {OPTION_SIDETONE_700,"700 Hz"},
      {OPTION_SIDETONE_750,"750 Hz"},
      {OPTION_SIDETONE_800,"800 Hz"},
      {OPTION_EXIT,"Exit"},
      {OPTION_NONE,"None"},
      {OPTION_NONE,"None"},
      {OPTION_NONE,"None"},
      {OPTION_NONE,"None"},
      {OPTION_NONE,"None"}
    }
  },
  {
    MENU_SIDETONE_LEVEL,
    "CW Level",
    4U,
    {
      {OPTION_SIDETONE_LOW,"Low"},
      {OPTION_SIDETONE_MED,"Medium"},
      {OPTION_SIDETONE_HI,"High"},
      {OPTION_EXIT,"Exit"},
      {OPTION_NONE,"None"},
      {OPTION_NONE,"None"},
      {OPTION_NONE,"None"},
      {OPTION_NONE,"None"},
      {OPTION_NONE,"None"},
      {OPTION_NONE,"None"},
      {OPTION_NONE,"None"}
    }
  },
  {
    MENU_CW_KEYER,
    "CW Keyer",
    3U,
    {
      {OPTION_IAMBIC_A,"Iambic A"},
      {OPTION_IAMBIC_B,"Iambic B"},
      {OPTION_EXIT,"Exit"},
      {OPTION_NONE,"None"},
      {OPTION_NONE,"None"},
      {OPTION_NONE,"None"},
      {OPTION_NONE,"None"},
      {OPTION_NONE,"None"},
      {OPTION_NONE,"None"},
      {OPTION_NONE,"None"},
      {OPTION_NONE,"None"}
    }
  },
  {
    MENU_GRAPH_SWR,
    "Graph SWR",
    3U,
    {
      {OPTION_GRAPH_SWR_Y,"Yes"},
      {OPTION_GRAPH_SWR_N,"No"},
      {OPTION_EXIT,"Exit"},
      {OPTION_NONE,"None"},
      {OPTION_NONE,"None"},
      {OPTION_NONE,"None"},
      {OPTION_NONE,"None"},
      {OPTION_NONE,"None"},
      {OPTION_NONE,"None"},
      {OPTION_NONE,"None"},
      {OPTION_NONE,"None"}
    }
  },
  {
    MENU_CESSB,
    "CESSB",
    3U,
    {
      {OPTION_CESSB_ON,"On"},
      {OPTION_CESSB_OFF,"Off"},
      {OPTION_EXIT,"Exit"},
      {OPTION_NONE,"None"},
      {OPTION_NONE,"None"},
      {OPTION_NONE,"None"},
      {OPTION_NONE,"None"},
      {OPTION_NONE,"None"},
      {OPTION_NONE,"None"},
      {OPTION_NONE,"None"},
      {OPTION_NONE,"None"}
    }
  },
  {
    MENU_CALLSIGN,
    "Callsign",
    3U,
    {
      {OPTION_CALL_RESET,"Clear"},
      {OPTION_CALL_REBOOT,"..Reboot"},
      {OPTION_EXIT,"Exit"},
      {OPTION_NONE,"None"},
      {OPTION_NONE,"None"},
      {OPTION_NONE,"None"},
      {OPTION_NONE,"None"},
      {OPTION_NONE,"None"},
      {OPTION_NONE,"None"},
      {OPTION_NONE,"None"},
      {OPTION_NONE,"None"}
    }
  },
  {
    MENU_EXIT,
    "Exit",
    1U,
    {
      {OPTION_EXIT,"Exit"},
      {OPTION_NONE,"None"},
      {OPTION_NONE,"None"},
      {OPTION_NONE,"None"},
      {OPTION_NONE,"None"},
      {OPTION_NONE,"None"},
      {OPTION_NONE,"None"},
      {OPTION_NONE,"None"},
      {OPTION_NONE,"None"},
      {OPTION_NONE,"None"},
      {OPTION_NONE,"None"}
    }
  }
};

#endif
