ianm8/MBPTRX/src/CW.h

#ifndef CW_H
#define CW_H

#include "util.h"

#define COS_SIN_TAB 125
#define GAUSSIAN_TAB 400

namespace CW
{
  // CW keying edge: integrated Gaussian (erf) S-curve, full scale -> 0
  // sigma = 57.74 samples (1.85 ms at 31250 Hz), span +/-3.45 sigma, 10-90% = 4.74 ms
  // symmetric: tab[n] + tab[GAUSSIAN_TAB-1-n] = 32767, so rise and fall have equal delay
  static const uint16_t __not_in_flash("fast_access_sram") gaussian_tab[GAUSSIAN_TAB] =
  {
    32767,
    32766,
    32766,
    32765,
    32764,
    32764,
    32763,
    32762,
    32761,
    32760,
    32759,
    32758,
    32757,
    32756,
    32754,
    32753,
    32752,
    32750,
    32749,
    32747,
    32745,
    32743,
    32741,
    32739,
    32737,
    32735,
    32732,
    32730,
    32727,
    32724,
    32721,
    32718,
    32715,
    32712,
    32708,
    32704,
    32700,
    32696,
    32691,
    32687,
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
  };

  static const int16_t __not_in_flash("fast_access_sram") dds_sin_tab[1024] =
  {
    (int16_t)32767,
    (int16_t)32766,
    (int16_t)32765,
    (int16_t)32761,
    (int16_t)32757,
    (int16_t)32752,
    (int16_t)32745,
    (int16_t)32737,
    (int16_t)32728,
    (int16_t)32717,
    (int16_t)32705,
    (int16_t)32692,
    (int16_t)32678,
    (int16_t)32663,
    (int16_t)32646,
    (int16_t)32628,
    (int16_t)32609,
    (int16_t)32589,
    (int16_t)32567,
    (int16_t)32545,
    (int16_t)32521,
    (int16_t)32495,
    (int16_t)32469,
    (int16_t)32441,
    (int16_t)32412,
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
    (int16_t)30919,
    (int16_t)30985,
    (int16_t)31050,
    (int16_t)31113,
    (int16_t)31176,
    (int16_t)31237,
    (int16_t)31297,
    (int16_t)31356,
    (int16_t)31414,
    (int16_t)31470,
    (int16_t)31526,
    (int16_t)31580,
    (int16_t)31633,
    (int16_t)31685,
    (int16_t)31736,
    (int16_t)31785,
    (int16_t)31833,
    (int16_t)31880,
    (int16_t)31926,
    (int16_t)31971,
    (int16_t)32014,
    (int16_t)32057,
    (int16_t)32098,
    (int16_t)32137,
    (int16_t)32176,
    (int16_t)32213,
    (int16_t)32250,
    (int16_t)32285,
    (int16_t)32318,
    (int16_t)32351,
    (int16_t)32382,
    (int16_t)32412,
    (int16_t)32441,
    (int16_t)32469,
    (int16_t)32495,
    (int16_t)32521,
    (int16_t)32545,
    (int16_t)32567,
    (int16_t)32589,
    (int16_t)32609,
    (int16_t)32628,
    (int16_t)32646,
    (int16_t)32663,
    (int16_t)32678,
    (int16_t)32692,
    (int16_t)32705,
    (int16_t)32717,
    (int16_t)32728,
    (int16_t)32737,
    (int16_t)32745,
    (int16_t)32752,
    (int16_t)32757,
    (int16_t)32761,
    (int16_t)32765,
    (int16_t)32766
  };

  static void __not_in_flash_func(process_cw)(const bool keydown,int16_t &out_i,int16_t &out_q)
  {
    static const int32_t cw_gain = 100;
    static const int32_t set_gain = cw_gain * 1024 / 100;
    static const int32_t max_sig = 361;
    volatile static uint32_t gaussian_phase = 0;
    volatile static enum cw_state_t
    {
      CW_STATE_KEYUP,
      CW_STATE_KEYDOWN,
      CW_STATE_KEY_TRANSITION_TO_DOWN,
      CW_STATE_KEY_TRANSITION_TO_UP
    }
    cw_state = CW_STATE_KEYUP;
    switch (cw_state)
    {
      case CW_STATE_KEYUP:
      {
        out_i = 0;
        out_q = 0;
        // if keydown then transition to key down
        if (keydown)
        {
          gaussian_phase = GAUSSIAN_TAB - 1;
          cw_state = CW_STATE_KEY_TRANSITION_TO_DOWN;
        }
        break;
      }
      case CW_STATE_KEY_TRANSITION_TO_DOWN:
      {
        // stay here until gaussian done
        const int32_t gaussian = gaussian_tab[gaussian_phase];
        out_i = out_q = (((max_sig * gaussian) >> 15) * set_gain) >> 10;
        gaussian_phase--;
        if (gaussian_phase==0)
        {
          cw_state = CW_STATE_KEYDOWN;
        }
        break;
      }
      case CW_STATE_KEYDOWN:
      {
        // stay here while key down
        out_i = out_q = (max_sig * set_gain) >> 10;
        if (keydown)
        {
          return;
        }
        gaussian_phase = 0;
        cw_state = CW_STATE_KEY_TRANSITION_TO_UP;
        break;
      }
      case CW_STATE_KEY_TRANSITION_TO_UP:
      {
        // stay here until gaussian done
        const int32_t gaussian = gaussian_tab[gaussian_phase];
        out_i = out_q = (((max_sig * gaussian) >> 15) * set_gain) >> 10;
        gaussian_phase++;
        if (gaussian_phase>=GAUSSIAN_TAB)
        {
          cw_state = CW_STATE_KEYUP;
        }
        break;
      }
    }
  }

  static const int16_t __not_in_flash_func(sidetone)(
      const bool keydown,
      const uint32_t phase,
      const uint32_t level)
  {
    const uint32_t shift = 8u - level;
    volatile static uint32_t dds = 0;
    // position in gaussian_tab: 0 = full level, GAUSSIAN_TAB-1 = silent
    // walks one entry per sample so the tone has the same edge as the RF
    static uint32_t envelope_phase = GAUSSIAN_TAB - 1;
    if (keydown)
    {
      if (envelope_phase>0)
      {
        envelope_phase--;
      }
    }
    else
    {
      if (envelope_phase<GAUSSIAN_TAB-1)
      {
        envelope_phase++;
      }
    }
    int16_t s = 0;
    if (envelope_phase<GAUSSIAN_TAB-1)
    {
      // scale tone by envelope, single rounded shift
      const int32_t envelope = gaussian_tab[envelope_phase];
      const int32_t tone_sample = dds_sin_tab[dds>>22];
      s = (int16_t)((tone_sample * envelope + (1 << (14 + shift))) >> (15 + shift));
    }
    dds += phase;
    return s;
  }
}

#endif
