ianm8/MBPTRX/src/fft2500.h

#pragma once
/*
 * fft2500.h  -  Fixed-size real-input FFT for N=2500
 *
 * Derived from KissFFT by Mark Borgerding (BSD-3-Clause).
 * All twiddle factors are precomputed as const arrays (flash storage).
 * No initialisation call needed. No heap allocation.
 * Modifications by Ian Mitchell VK7IAN.
 *
 * Static flash usage:
 *   k_twiddles       1250 cpx * 8 =  10000 bytes
 *   k_super_twiddles  625 cpx * 8 =   5000 bytes
 *   Total                          =  15000 bytes (~15 KB flash)
 *
 * RAM usage (BSS):
 *   g_tmpbuf         1250 cpx * 8 =  10000 bytes
 *
 * Public API:
 *   fft2500_real(const float *in, kiss_fft_cpx *out)
 *     in[0..2499]  : 2500 real samples
 *     out[0..1250] : 1251 complex bins (DC to Nyquist)
 *
 *   ft8_fft_forward(float *re, float *im)
 *     ft8_codec.h compatible wrapper
 *
 * BSD-3-Clause License - see bottom of file.
 */

#ifndef M_PI
#define M_PI 3.14159265358979323846
#endif

 /* --------------------------------------------------------------------------
  * Types - identical to KissFFT so ft8_lib code needs no changes
  * -------------------------------------------------------------------------- */
typedef float kiss_fft_scalar;

typedef struct
{
  kiss_fft_scalar r;
  kiss_fft_scalar i;
} kiss_fft_cpx;

/* --------------------------------------------------------------------------
 * Sizes
 * -------------------------------------------------------------------------- */
#define FFT2500_NFFT    2500
#define FFT2500_NCPX    1250    /* complex sub-FFT length   */
#define FFT2500_NBINS   1251    /* output bins 0..N/2       */
#define FFT2500_NSTAGES    5

 /* Complex sub-FFT twiddles: k_twiddles[k] = exp(-j*2*pi*k/1250) */
static const kiss_fft_cpx k_twiddles[FFT2500_NCPX] =
{
  { 1.000000000f, -0.000000000f }, // k = 0
  { 0.999987364f, -0.005026527f }, // k = 1
  { 0.999949455f, -0.010052927f }, // k = 2
  { 0.999886334f, -0.015079074f }, // k = 3
  { 0.999797881f, -0.020104839f }, // k = 4
  { 0.999684215f, -0.025130095f }, // k = 5
  { 0.999545217f, -0.030154718f }, // k = 6
  { 0.999381065f, -0.035178579f }, // k = 7
  { 0.999191582f, -0.040201548f }, // k = 8
  { 0.998976886f, -0.045223504f }, // k = 9
  { 0.998736978f, -0.050244316f }, // k = 10
  { 0.998471797f, -0.055263862f }, // k = 11
  { 0.998181403f, -0.060282011f }, // k = 12
  { 0.997865796f, -0.065298632f }, // k = 13
  { 0.997524917f, -0.070313610f }, // k = 14
  { 0.997158885f, -0.075326808f }, // k = 15
  { 0.996767700f, -0.080338098f }, // k = 16
  { 0.996351242f, -0.085347362f }, // k = 17
  { 0.995909691f, -0.090354472f }, // k = 18
  { 0.995442927f, -0.095359296f }, // k = 19
  { 0.994951010f, -0.100361712f }, // k = 20
  { 0.994433999f, -0.105361596f }, // k = 21
  { 0.993891835f, -0.110358812f }, // k = 22
  { 0.993324518f, -0.115353242f }, // k = 23
  { 0.992732167f, -0.120344758f }, // k = 24
  { 0.992114723f, -0.125333235f }, // k = 25
  { 0.991472185f, -0.130318537f }, // k = 26
  { 0.990804613f, -0.135300562f }, // k = 27
  { 0.990112007f, -0.140279159f }, // k = 28
  { 0.989394367f, -0.145254210f }, // k = 29
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
  { -0.087851182f, -0.996133626f }, // 34
  { -0.090354592f, -0.995909631f }, // 35
  { -0.092857316f, -0.995679438f }, // 36
  { -0.095359325f, -0.995442927f }, // 37
  { -0.097860858f, -0.995200098f }, // 38
  { -0.100361772f, -0.994951010f }, // 39
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
};

/*
  for (int k = 0; k < N_FFT; ++k)
  {
    const float x = sinf((float)M_PI * k / N_FFT);
    const float hann = (2.0f / (float)N_FFT) * x * x;
    printf("    { %.12ff }, // k = %d\n", hann, k);
  }
*/
static const float hann_window[FFT2500_NFFT] =
{
  0.000000000000f, // k = 0
  0.000000001263f, // k = 1
  0.000000005053f, // k = 2
  0.000000011370f, // k = 3
  0.000000020213f, // k = 4
  0.000000031582f, // k = 5
  0.000000045478f, // k = 6
  0.000000061901f, // k = 7
  0.000000080849f, // k = 8
  0.000000102324f, // k = 9
  0.000000126324f, // k = 10
  0.000000152851f, // k = 11
  0.000000181903f, // k = 12
  0.000000213480f, // k = 13
  0.000000247583f, // k = 14
  0.000000284211f, // k = 15
  0.000000323364f, // k = 16
  0.000000365041f, // k = 17
  0.000000409242f, // k = 18
  0.000000455968f, // k = 19
  0.000000505217f, // k = 20
  0.000000556990f, // k = 21
  0.000000611286f, // k = 22
  0.000000668105f, // k = 23
  0.000000727446f, // k = 24
  0.000000789309f, // k = 25
  0.000000853693f, // k = 26
  0.000000920599f, // k = 27
  0.000000990026f, // k = 28
  0.000001061973f, // k = 29
  0.000001136440f, // k = 30
  0.000001213426f, // k = 31
  0.000001292932f, // k = 32
  0.000001374956f, // k = 33
  0.000001459498f, // k = 34
  0.000001546557f, // k = 35
  0.000001636132f, // k = 36
  0.000001728224f, // k = 37
  0.000001822833f, // k = 38
  0.000001919956f, // k = 39
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
};

/* Hard-coded factor pairs for 1250 = 5*5*5*5*2
 * KissFFT format: [radix, remaining_length, ..., 0, 0 sentinel] */
static const int k_factors[FFT2500_NSTAGES * 2 + 2] =
{
  5,250,  5,50,  5,10,  5,2,  2,1,  0,0
};

/* RAM work buffer - 10 KB in BSS */
static kiss_fft_cpx g_tmpbuf[FFT2500_NCPX];

/* --------------------------------------------------------------------------
 * Minimal state struct - points into const flash tables, no init needed
 * -------------------------------------------------------------------------- */
typedef struct
{
  int          nfft;
  int          nfactors;
  const int* factors;
  const kiss_fft_cpx* twiddles;
} fft2500_state_t;

static const fft2500_state_t k_st =
{
  FFT2500_NCPX,
  FFT2500_NSTAGES,
  k_factors,
  k_twiddles
};

/* --------------------------------------------------------------------------
 * Radix-2 butterfly
 * tw advances by fstride each iteration (uses *tw pointer walk).
 * -------------------------------------------------------------------------- */
static void kf_bfly2(kiss_fft_cpx* Fout, int fstride,
  const fft2500_state_t* st, int m)
{
  kiss_fft_cpx* Fout2 = Fout + m;
  const kiss_fft_cpx* tw = st->twiddles;
  do
  {
    const float ar = Fout->r;
    const float ai = Fout->i;
    const float br = Fout2->r;
    const float bi = Fout2->i;
    const float wr = tw->r;
    const float wi = tw->i;
    const float tr = br * wr - bi * wi;
    const float ti = br * wi + bi * wr;
    Fout2->r = ar - tr;
    Fout2->i = ai - ti;
    Fout->r = ar + tr;
    Fout->i = ai + ti;
    tw += fstride;
    ++Fout2; ++Fout;
  } while (--m);
}

/* --------------------------------------------------------------------------
 * Radix-5 butterfly
 * Twiddles accessed by explicit index from fixed base - tw must NOT advance.
 * ya = W_N^(N/5), yb = W_N^(2N/5) read from twiddle table.
 * -------------------------------------------------------------------------- */
static void kf_bfly5(kiss_fft_cpx* Fout, int fstride,
  const fft2500_state_t* st, int m)
{
  const kiss_fft_cpx* tw = st->twiddles;   /* fixed base, never moved */
  const kiss_fft_cpx ya = tw[fstride * m];
  const kiss_fft_cpx yb = tw[fstride * 2 * m];

  kiss_fft_cpx* Fout0 = Fout;
  kiss_fft_cpx* Fout1 = Fout + m;
  kiss_fft_cpx* Fout2 = Fout + 2 * m;
  kiss_fft_cpx* Fout3 = Fout + 3 * m;
  kiss_fft_cpx* Fout4 = Fout + 4 * m;

  for (int u = 0; u < m; ++u)
  {
    kiss_fft_cpx scratch[13];
    const float F0r = Fout0->r;
    const float F0i = Fout0->i;

    /* Apply twiddle factors W^(k*u) for k=1..4 */
    const kiss_fft_cpx* tw1 = &tw[u * fstride];
    const kiss_fft_cpx* tw2 = &tw[2 * u * fstride];
    const kiss_fft_cpx* tw3 = &tw[3 * u * fstride];
    const kiss_fft_cpx* tw4 = &tw[4 * u * fstride];

    scratch[1].r = Fout1->r * tw1->r - Fout1->i * tw1->i;
    scratch[1].i = Fout1->r * tw1->i + Fout1->i * tw1->r;
    scratch[2].r = Fout2->r * tw2->r - Fout2->i * tw2->i;
    scratch[2].i = Fout2->r * tw2->i + Fout2->i * tw2->r;
    scratch[3].r = Fout3->r * tw3->r - Fout3->i * tw3->i;
    scratch[3].i = Fout3->r * tw3->i + Fout3->i * tw3->r;
    scratch[4].r = Fout4->r * tw4->r - Fout4->i * tw4->i;
    scratch[4].i = Fout4->r * tw4->i + Fout4->i * tw4->r;

    scratch[7].r = scratch[1].r + scratch[4].r;
    scratch[7].i = scratch[1].i + scratch[4].i;
    scratch[10].r = scratch[1].r - scratch[4].r;
    scratch[10].i = scratch[1].i - scratch[4].i;
    scratch[8].r = scratch[2].r + scratch[3].r;
    scratch[8].i = scratch[2].i + scratch[3].i;
    scratch[9].r = scratch[2].r - scratch[3].r;
    scratch[9].i = scratch[2].i - scratch[3].i;

    Fout0->r = F0r + scratch[7].r + scratch[8].r;
    Fout0->i = F0i + scratch[7].i + scratch[8].i;

    scratch[5].r = F0r + scratch[7].r * ya.r + scratch[8].r * yb.r;
    scratch[5].i = F0i + scratch[7].i * ya.r + scratch[8].i * yb.r;
    scratch[6].r = scratch[10].i * ya.i + scratch[9].i * yb.i;
    scratch[6].i = -scratch[10].r * ya.i - scratch[9].r * yb.i;

    /* Note: Fout1 = scratch[5] - scratch[6]  (NOT +)  */
    Fout1->r = scratch[5].r - scratch[6].r;
    Fout1->i = scratch[5].i - scratch[6].i;
    Fout4->r = scratch[5].r + scratch[6].r;
    Fout4->i = scratch[5].i + scratch[6].i;

    scratch[11].r = F0r + scratch[7].r * yb.r + scratch[8].r * ya.r;
    scratch[11].i = F0i + scratch[7].i * yb.r + scratch[8].i * ya.r;
    scratch[12].r = -scratch[10].i * yb.i + scratch[9].i * ya.i;
    scratch[12].i = scratch[10].r * yb.i - scratch[9].r * ya.i;

    Fout2->r = scratch[11].r + scratch[12].r;
    Fout2->i = scratch[11].i + scratch[12].i;
    Fout3->r = scratch[11].r - scratch[12].r;
    Fout3->i = scratch[11].i - scratch[12].i;

    ++Fout0; ++Fout1; ++Fout2; ++Fout3; ++Fout4;
  }
}

/* --------------------------------------------------------------------------
 * Recursive FFT core  (from KissFFT kf_work)
 * OUT-OF-PLACE DIT: reads f[] strided, writes Fout[] contiguous.
 * -------------------------------------------------------------------------- */
static void kf_work(kiss_fft_cpx* Fout, const kiss_fft_cpx* f,
  int fstride, int in_stride,
  const int* factors, const fft2500_state_t* st)
{
  kiss_fft_cpx* Fout_beg = Fout;
  const int p = *factors++;
  const int m = *factors++;
  const kiss_fft_cpx* Fout_end = Fout + p * m;

  if (m == 1)
  {
    do { *Fout = *f; f += fstride * in_stride; } while (++Fout != Fout_end);
  }
  else
  {
    kiss_fft_cpx* f2 = Fout;
    do
    {
      kf_work(f2, f, fstride * p, in_stride, factors, st);
      f += fstride * in_stride;
      f2 += m;
    } while (f2 != Fout_end);
  }
  Fout = Fout_beg;
  switch (p)
  {
  case 2: kf_bfly2(Fout, fstride, st, m); break;
  case 5: kf_bfly5(Fout, fstride, st, m); break;
  }
}

/* --------------------------------------------------------------------------
 * Real-input FFT of N=2500  (public)
 *
 * in[0..2499]  : 2500 real samples
 * out[0..1250] : 1251 complex bins DC..Nyquist
 * -------------------------------------------------------------------------- */
static void fft2500_real(const float* in, kiss_fft_cpx* out)
{
  /* Complex FFT (real packed as interleaved complex) */
  kf_work(g_tmpbuf, (const kiss_fft_cpx*)in, 1, 1, k_st.factors, &k_st);

  /* ---- DC and Nyquist ---- */
  const float t0r = g_tmpbuf[0].r;
  const float t0i = g_tmpbuf[0].i;

  out[0].r = t0r + t0i;
  out[0].i = 0.0f;

  out[FFT2500_NCPX].r = t0r - t0i;
  out[FFT2500_NCPX].i = 0.0f;

  /* ---- Main recombination ---- */
  const int ncpx = FFT2500_NCPX;

  for (int k = 1; k <= ncpx / 2; ++k)
  {
    /* Load inputs */
    const kiss_fft_cpx* fk = &g_tmpbuf[k];
    const kiss_fft_cpx* fnk = &g_tmpbuf[ncpx - k];
    const float fpk_r = fk->r;
    const float fpk_i = fk->i;
    const float fpnk_r = fnk->r;
    const float fpnk_i = -fnk->i;   /* conjugate */

    /* f1k = fpk + fpnk */
    const float f1r = fpk_r + fpnk_r;
    const float f1i = fpk_i + fpnk_i;

    /* f2k = fpk - fpnk */
    const float f2r = fpk_r - fpnk_r;
    const float f2i = fpk_i - fpnk_i;

    /* Twiddle */
    const float wr = k_super_twiddles[k - 1].r;
    const float wi = k_super_twiddles[k - 1].i;

    /* tmp = f2k * tw */
    const float tr = f2r * wr - f2i * wi;
    const float ti = f2r * wi + f2i * wr;

    /* Output */
    kiss_fft_cpx* ok = &out[k];
    kiss_fft_cpx* onk = &out[ncpx - k];
    ok->r = 0.5f * (f1r + tr);
    ok->i = 0.5f * (f1i + ti);
    onk->r = 0.5f * (f1r - tr);
    onk->i = -0.5f * (f1i - ti);
  }
}

/* --------------------------------------------------------------------------
 * ft8_codec.h wrapper
 * Entry: re[0..2499]=real samples, im[]=0
 * Exit:  re[k],im[k]=spectrum bins k=0..1250; zeros above
 * -------------------------------------------------------------------------- */
static void ft8_fft_forward(float* re, float* im)
{
  static kiss_fft_cpx out[FFT2500_NBINS];
  fft2500_real(re, out);
  for (int k = 0; k < FFT2500_NBINS; ++k) { re[k] = out[k].r; im[k] = out[k].i; }
  for (int k = FFT2500_NBINS; k < FFT2500_NFFT; ++k) { re[k] = 0.0f; im[k] = 0.0f; }
}

/*
 * BSD 3-Clause License
 * Copyright (c) 2003-2010 Mark Borgerding
 * Redistribution and use in source and binary forms, with or without
 * modification, are permitted provided that the following conditions are met:
 * 1. Redistributions of source code must retain the above copyright notice.
 * 2. Redistributions in binary form must reproduce the above copyright notice.
 * 3. Neither the name of the copyright holder nor the names of its contributors
 *    may be used to endorse or promote products derived from this software.
 * THIS SOFTWARE IS PROVIDED "AS IS" WITHOUT WARRANTY OF ANY KIND.
 */
