ianm8/MBPTRX/src/ArialBold14pt7b.h

static const uint8_t Arial_Bold14pt7bBitmaps[] = {
  0x00, 0xFF, 0xFF, 0xFF, 0xFF, 0xF7, 0x66, 0x66, 0x00, 0xFF, 0xFF, 0xF3,
  0xFC, 0xFF, 0x3F, 0xCF, 0xF3, 0xFC, 0xF7, 0x1C, 0x07, 0x1C, 0x0E, 0x38,
  0x3C, 0xF0, 0x71, 0xC0, 0xE3, 0x9F, 0xFF, 0xFF, 0xFF, 0xFF, 0xFF, 0x1C,
  0x70, 0x38, 0xE0, 0x71, 0xC0, 0xE3, 0x8F, 0xFF, 0xFF, 0xFF, 0xFF, 0xFF,
  0x9C, 0x70, 0x38, 0xE0, 0xF3, 0xC1, 0xC7, 0x03, 0x8E, 0x00, 0x06, 0x01,
  0xF8, 0x3F, 0xC7, 0xFE, 0xF6, 0xFE, 0x67, 0xE6, 0x0E, 0x60, 0xFE, 0x07,
  0xF0, 0x7F, 0xC1, 0xFE, 0x07, 0xF0, 0x6F, 0x06, 0x7E, 0x67, 0xF6, 0x77,
  0x6F, 0x7F, 0xE3, 0xFC, 0x1F, 0x80, 0x60, 0x06, 0x00, 0x3E, 0x03, 0x81,
  0xFC, 0x0E, 0x0E, 0x38, 0x70, 0x38, 0xE1, 0xC0, 0xE3, 0x8F, 0x03, 0x8E,
  0x38, 0x0E, 0x38, 0xE0, 0x38, 0xE7, 0x00, 0x7F, 0x1C, 0x00, 0xF8, 0xE0,
  0x00, 0x03, 0x80, 0x00, 0x1C, 0x7C, 0x00, 0x73, 0xF8, 0x03, 0x9C, 0x70,
  0x0E, 0x71, 0xC0, 0x71, 0xC7, 0x01, 0xC7, 0x1C, 0x0E, 0x1C, 0x70, 0x38,
  0x71, 0xC1, 0xC0, 0xFE, 0x07, 0x01, 0xF0, 0x07, 0xC0, 0x07, 0xFC, 0x03,
  0xFF, 0x80, 0xF1, 0xE0, 0x3C, 0x78, 0x0F, 0x1E, 0x01, 0xEF, 0x00, 0x7F,
  0x80, 0x0F, 0xC0, 0x07, 0xF0, 0x03, 0xFC, 0x01, 0xFF, 0x9C, 0xF9, 0xFF,
  0x3C, 0x3F, 0xCF, 0x07, 0xE3, 0xC1, 0xF8, 0xF8, 0xFF, 0x9F, 0xFF, 0xF3,
  0xFE, 0x78, 0x3F, 0x0C, 0xFF, 0xFF, 0xFF, 0x70, 0x0E, 0x38, 0x71, 0xE3,
  0x8F, 0x1E, 0x38, 0xF1, 0xE3, 0xC7, 0x8F, 0x1E, 0x3C, 0x78, 0xF0, 0xE1,
  0xE3, 0xC3, 0x87, 0x87, 0x0E, 0x0E, 0xE0, 0xE1, 0xC3, 0xC3, 0x87, 0x8F,
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
  {  1056,  14,  20,  17,    2,  -19 },   // 0x46 'F'
  {  1091,  18,  20,  21,    1,  -19 },   // 0x47 'G'
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

static const GFXfont Arial_Bold14pt7b = {
  (uint8_t  *)Arial_Bold14pt7bBitmaps,
  (GFXglyph *)Arial_Bold14pt7bGlyphs,
  0x20, 0x7E, 32 };

// Approx. 3501 bytes
