ianm8/MBPTRX/src/ArialBold16pt7b.h

static const uint8_t Arial_Bold16pt7bBitmaps[] = {
  0x00, 0xFF, 0xFF, 0xFF, 0xFF, 0xFF, 0xF6, 0x66, 0x66, 0x00, 0xFF, 0xFF,
  0xF1, 0xFE, 0x3F, 0xC7, 0xF8, 0xFF, 0x1F, 0xE3, 0xFC, 0x7B, 0x06, 0x03,
  0x87, 0x01, 0xC3, 0x81, 0xE3, 0xC0, 0xE1, 0xC0, 0x70, 0xE0, 0x38, 0x73,
  0xFF, 0xFF, 0xFF, 0xFF, 0xFF, 0xFF, 0x87, 0x0E, 0x03, 0x87, 0x03, 0x87,
  0x01, 0xC3, 0x87, 0xFF, 0xFF, 0xFF, 0xFF, 0xFF, 0xFF, 0x38, 0x70, 0x1C,
  0x38, 0x0E, 0x1C, 0x07, 0x0E, 0x07, 0x0E, 0x03, 0x87, 0x00, 0x03, 0x00,
  0x0C, 0x00, 0xFC, 0x0F, 0xFC, 0x7F, 0xF9, 0xFF, 0xEF, 0xB7, 0xFC, 0xCF,
  0xF3, 0x03, 0xCC, 0x0F, 0xF0, 0x1F, 0xE0, 0x3F, 0xF0, 0x7F, 0xE0, 0x3F,
  0x80, 0xDF, 0x03, 0x3F, 0xCC, 0xFF, 0x33, 0xFE, 0xDF, 0x7F, 0xF8, 0xFF,
  0xE3, 0xFF, 0x03, 0xF0, 0x03, 0x00, 0x0C, 0x00, 0x30, 0x00, 0x3E, 0x01,
  0xC0, 0xFE, 0x03, 0x83, 0xDE, 0x0E, 0x07, 0x1C, 0x1C, 0x0E, 0x38, 0x78,
  0x1C, 0x70, 0xE0, 0x38, 0xE3, 0xC0, 0x71, 0xC7, 0x00, 0xF7, 0x0E, 0x00,
  0xFE, 0x38, 0x00, 0xF8, 0x70, 0x00, 0x01, 0xC0, 0x00, 0x03, 0x8F, 0x80,
  0x0E, 0x3F, 0x80, 0x1C, 0xF7, 0x80, 0x71, 0xC7, 0x00, 0xE3, 0x8E, 0x03,
  0x87, 0x1C, 0x07, 0x0E, 0x38, 0x1C, 0x1C, 0x70, 0x38, 0x3D, 0xC0, 0xE0,
  0x3F, 0x81, 0xC0, 0x3E, 0x00, 0x07, 0xF0, 0x00, 0xFF, 0x80, 0x1F, 0xFC,
  0x03, 0xE3, 0xE0, 0x3C, 0x1E, 0x03, 0xC1, 0xE0, 0x3E, 0x3E, 0x01, 0xF7,
  0xC0, 0x0F, 0xF8, 0x00, 0x7F, 0x00, 0x1F, 0xE0, 0x03, 0xFF, 0x00, 0x7D,
  0xF9, 0xEF, 0x8F, 0xBC, 0xF0, 0x7F, 0xCF, 0x03, 0xFC, 0xF0, 0x1F, 0x8F,
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
  {  1285,  15,  22,  19,    2,  -21 },   // 0x46 'F'
  {  1327,  21,  22,  24,    1,  -21 },   // 0x47 'G'
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

static const GFXfont Arial_Bold16pt7b = {
  (uint8_t  *)Arial_Bold16pt7bBitmaps,
  (GFXglyph *)Arial_Bold16pt7bGlyphs,
  0x20, 0x7E, 36 };

// Approx. 4127 bytes
