ianm8/MBPTRX/(commit log)

2025-10-07 PCB Complete V1.1
2025-10-07 Revision 1.1 PCB
2025-10-08 Revision 1.2
    This revision only changes a few component values for BOM consolidation.
2025-10-16 PCB Bottom View
2025-10-25 Revision 1.2
    [BOM_MBPTRX_2025-10-25.csv]
2025-10-25 Revision 1.2 BOM and build notes
2025-11-05 Arduino build notes
2026-04-16 Version 4.3.240
    Fix typo
    [MBPTRX.ino]
2026-05-31 Version 5.1.240
    Refactor FT8 button press code.
2026-06-06 Version 5.4.240
    I noticed the spectrum seemed less responsive. Seems the issue was forcing the buffers to be sequential, as in, process buffer A then buffer B, then buffer A, etc. Put it back to how it was so now if a buffer gets missed we don't wait around for the next different buffer, so buffer A, buffer B, buffer A, buffer A, buffer B, is fine!
    [MBPTRX.ino]
2026-06-09 Version 2.7.240
    Fix FT8 modifier seen as callsign,
    [MBPTRX.ino, ft8ui.h]
2026-06-11 Update README with FT8
    Added images for built-in FT8 and completed PCB.
2026-07-05 Fix component name for FOX924B-26
    U13 should be FOX924B, although any 3.3V CMOS TCXO of the right size should work for frequencies between 25 and 27 MHz.
    [BOM_MBPTRX_2025-10-25.csv]
2026-07-05 Version 5.9.240
    S-meter sensitivity fix.
    [MBPTRX.ino, dsp.h]
2026-08-08 Add notch filter to features list in README
2026-08-16 Version 6.8.240
    After stack fixes, can now run DSP on core1
    [MBPTRX.ino]
2026-09-25 Update capacitor specifications in README.md
2026-09-25 Update capacitor specifications in README
    Clarified specifications for 22uF and 100uF capacitors.
2026-10-12 Update resistor power rating in README
2026-10-12 Add case information to README
    Added information about a suitable case for the PCB.
2026-10-12 Update README with heatsink details and build notes
    Added heatsink information and reorganized build notes.
2026-10-12 Fix section headers in PCB README
    Updated section headers for Case and Heatsink in README.
